effevee/effevees_weerstation/documentatie/effevees_weerstation.pdf

## Effevee’s Weerstation

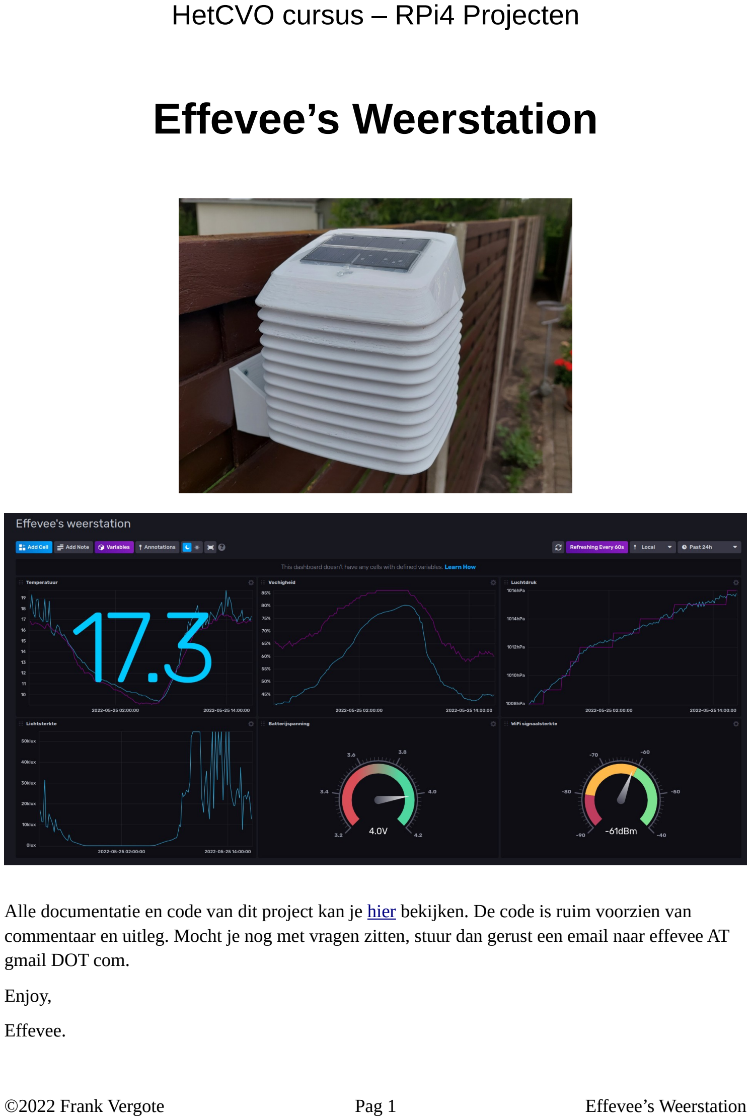
[picture p1: page 1]

HetCVO cursus – RPi4 Projecten

Alle documentatie en code van dit project kan je hier (https://github.com/effevee/effevees_weerstation) bekijken. De code is ruim voorzien van commentaar en uitleg. Mocht je nog met vragen zitten, stuur dan gerust een email naar effevee AT gmail DOT com.

Enjoy,

Effevee.

©2022 Frank Vergote | Pag 1 | Effevee’s Weerstation

Inhoudsopgave

©2022 Frank Vergote | Pag 2 | Effevee’s Weerstation

©2022 Frank Vergote | Pag 3 | Effevee’s Weerstation

Beschrijving

Effevee’s weerstation bestaat uit een buiten meetstation gebaseerd op een ESP32 (https://www.espressif.com/en/products/socs/esp32) microcontroller met sensoren voor temperatuur, vochtigheid, luchtdruk en licht intensiteit. Het autonome meetstation wordt gevoed door een lithium 18650 batterij met aangepaste 3,3V spanningsregelaar. De batterij wordt met een 6V 100mA 0,6W zonnepaneeltje en een TP4056 controller veilig opgeladen. De sturing van het meetstation is geprogrammeerd in MicroPython. (https://micropython.org/)

De meetresultaten inclusief de batterijspanning en de WiFi signaalsterkte worden doorgegeven naar de Raspberry Pi (https://www.raspberrypi.org/) backend mosquitto (https://mosquitto.org/) MQTT broker. Deze worden vervolgens met tele (https://docs.influxdata.com/telegraf/v1.21/) g (https://docs.influxdata.com/telegraf/v1.21/) raf (https://docs.influxdata.com/telegraf/v1.21/) doorgestuurd naar een influxdb (https://www.influxdata.com/) database. De meetgegevens worden tenslotte gevisualiseerd in een influxdb dashboard (Chronograf) in de browser. Als de batterijspanning te laag wordt stuurt influxdb (Kapacitor) een email. Alle nodige software op de backend wordt met docker (https://www.docker.com/) containers geïnstalleerd.

Materiaal

Meetstation

- DOIT ESP-WROOM-32 ontwikkelbordje
- AM2320 temperatuur- en vochtigheidssensor
- BMP180 luchtdruk- en temperatuursensor
- BH1750 licht intensiteitssensor
- Lithium Ion 18650 batterij 2500 mAh + batterijhouder
- Zonnepaneel 6V 100mA 0,6W – 90x60 mm
- TP4056 lithium batterij laad- en beschermingsmodule + 10k weerstand
- HT7333 3,3V spanningsregelaar + 2 100µF/16V elektrolytische condensatoren
- Batterijspanning monitoring : weerstanden 27k + 100k, condensator 100nF

Backend

- Raspberry Pi 4 Model B 2GB
- Aluminium passieve koeler behuizing
- SanDisk Ultra Fit USB 3.1 Flash Drive
- Originele Pi USB-C 3A voeding
©2022 Frank Vergote | Pag 4 | Effevee’s Weerstation

Meetstation

Microcontroller

We maken gebruik van het DOIT ESP-WROOM-32 ontwikkelbordje dat vlot verkrijgbaar is. De ESP32 heeft 2 processor cores aan boord, communiceert via WiFi en BLE (bluetooth low energy). De klok gaat tot 240 MHz. Er is 4 MB RAM geheugen en allerlei protocollen worden ondersteund zoals capacitive touch, ADC, DAC UART, SPI, I2C, …

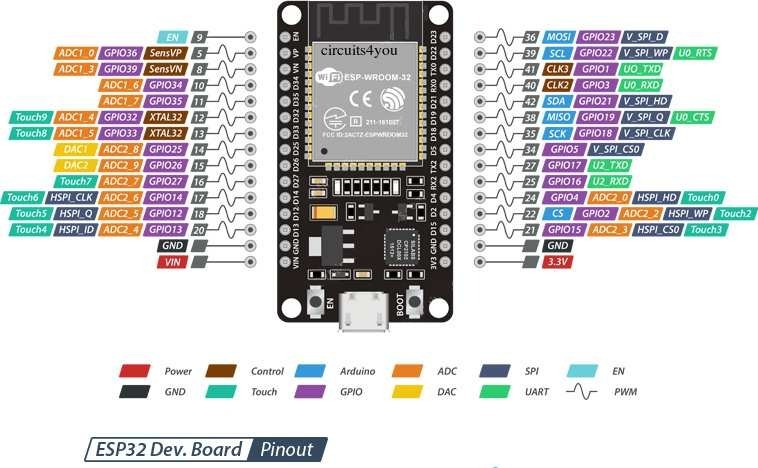
[picture p2: figure]

©2022 Frank Vergote | Pag 5 | Effevee’s Weerstation

Sensoren

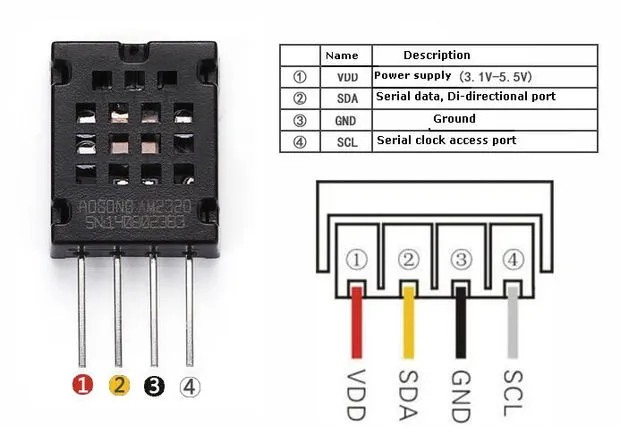
[picture p3: figure]

AM2320 temperatuur- en
vochtigheidssensor

De AOSONG AM2320 compacte sensor is de opvolger van de verouderde DT11/DT22 sensoren. De sensor is redelijk nauwkeurig, vergt weinig stroom en is simpel aan te sturen via I2C op adres 0x5C.

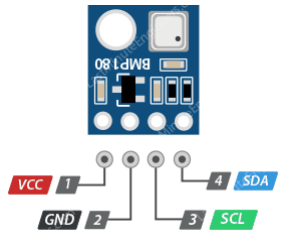
[picture p4: figure]

BMP180 luchtdruk- en temperatuursensor

De Bosch BMP180 is een zeer energiezuinige barometrische druksensor met hoge gevoeligheid. Doordat de druk in relatie staat tot de hoogte waarop je je bevindt kun je ook uitrekenen op welke hoogte boven zeeniveau de sensor zich bevindt. De sensor is aan te sturen via I2C op adres 0xD0.

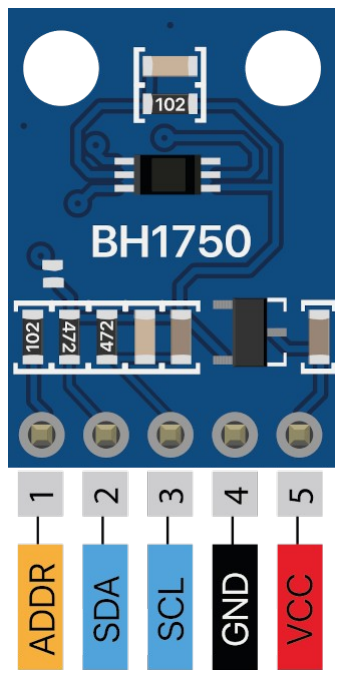
[picture p5: figure]

BH1750 licht intensiteitssensor

De Mouser BH1750 sensor wordt eveneens aangestuurd via I2C op adres 0x23, heeft een hoge resolutie (1-65235 lux) en is energie zuinig met zijn powerdown functie.

©2022 Frank Vergote | Pag 6 | Effevee’s Weerstation

Voeding

De voeding bestaat uit volgende onderdelen :

Lithium Ion 18650 batterij 2500 mAh

Een lithium ion batterij heeft een hoge energiedichtheid en een geringe zelfontlading. Bovendien heeft ze geen last van geheugeneffect (capaciteitsvermindering bij opladen voordat ze volledig ontladen is). De nominale spanning (bij 50% lading) is 3,7V. Bij volledig opladen moet de spanning beperkt worden tot 4,2V. Het is af te raden om de cel onder de 2,4V te laten ontladen. De cel kan ongeveer 2000 keer volledig geladen/ontladen worden. Niet gebruikte cellen worden best op hun nominale spanning bij kamertemperatuur gestockeerd.

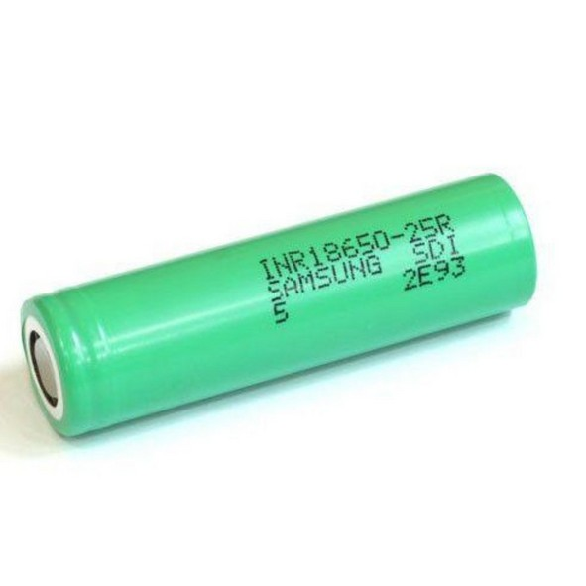
[picture p6: figure]
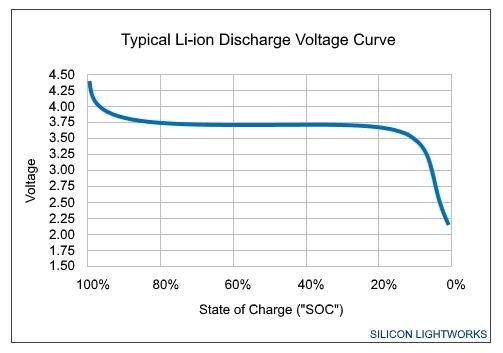
[picture p7: figure]

Hiernaast zie je een typische ontlaad curve van een lithium ion cel. De maximale spanning van 4,2V verlaagt heel snel naar de nominale spanning van 3,7V maar die blijft dan heel lang stabiel tot ongeveer 10% van de lading. Daarna gaat het heel snel bergaf tot de minimum spanning.

Zonnepaneel 6V 100mA 0,6W – 90x60 mm

Dit paneeltje bevat 12 cellen die elk ongeveer 0,5V kunnen leveren.

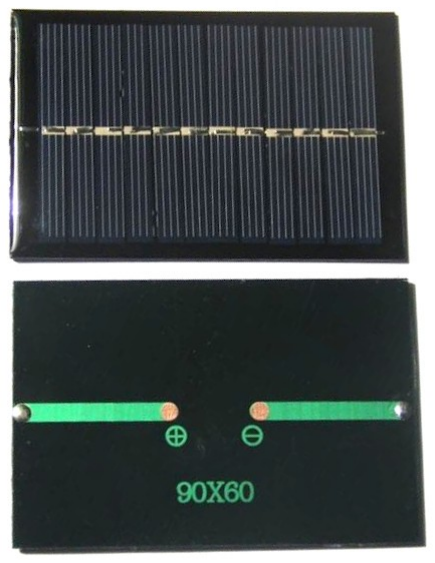
[picture p8: figure]

©2022 Frank Vergote | Pag 7 | Effevee’s Weerstation

TP4056 lithium batterij laad-en beschermingsmodule

Deze TP4056 (https://www.addicore.com/TP4056-Charger-and-Protection-Module-p/ad310.htm) beschermings (https://www.addicore.com/TP4056-Charger-and-Protection-Module-p/ad310.htm) module (https://www.addicore.com/TP4056-Charger-and-Protection-Module-p/ad310.htm) bevat een TP4056 chip die een 3,7V lithium batterij oplaadt via een constante stroom/constante spanning methode (CC/CV) tot 4,2V.

De DW01A chip houdt de spanning van de batterij in de gaten en stuurt de FS8204A transistor om de load af te schakelen indien de spanning onder de 2,4V dreigt te gaan. Die blijft afgeschakeld tot de spanning terug boven de 3,0V is. Daarnaast zorgt deze beschermingschip er ook voor dat de batterij tot maximaal 4,2V geladen wordt en dat de ontlaad stroom onder de 3A blijft.

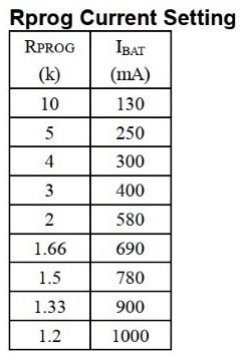
[picture p9: figure]

Als de spanning onder de 2,9V ligt
wordt de batterij met een verlaagde

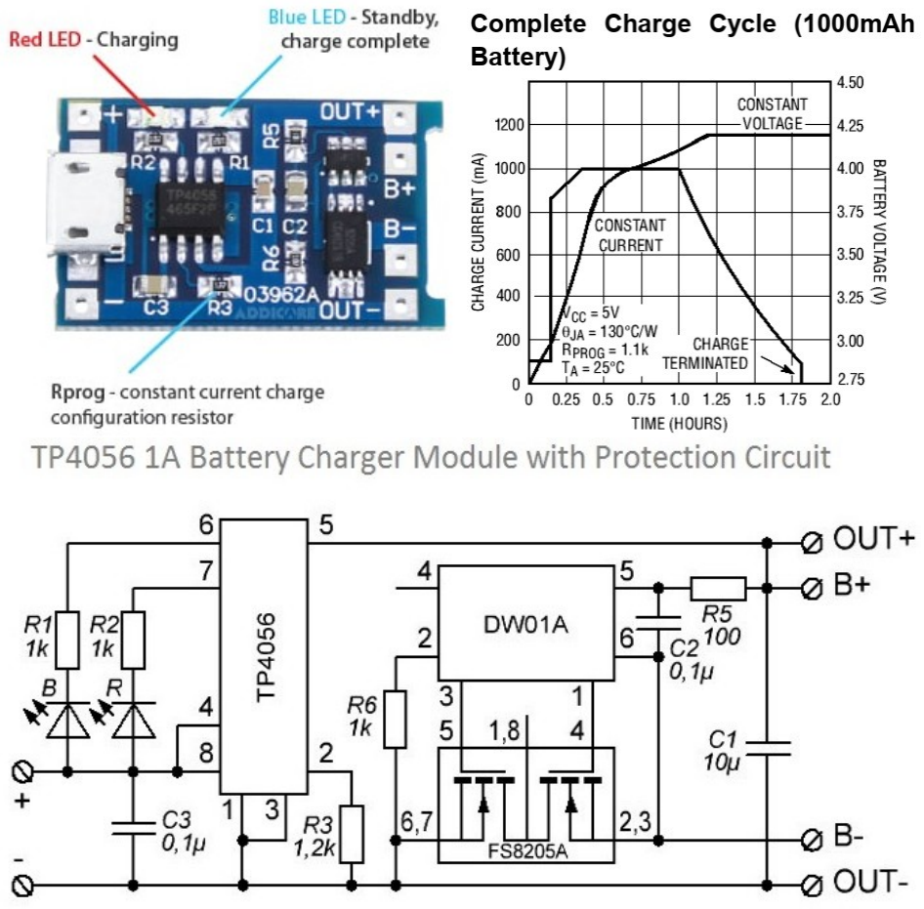
[picture p10: figure]

stroom (130mA) opgeladen tot 2,9V. Daarna wordt de stroom lineair opgevoerd tot de maximum laadstroom die bepaald wordt door de waarde van de weerstand R3 op de module (standaard 1,2k = 1A)

Het zonnepaneeltje levert maximaal 100 mA stroom, dus kunnen we de TP4056 module best aanpassen voor deze stroom. Hiervoor heb ik een 10k gesoldeerd op R3 zodat de laadstroom beperkt wordt tot 130mA. Het zonnepaneel levert maximaal 6V en kan dus rechtstreeks op de input van de TP4056 module worden aangesloten (max 8V input)

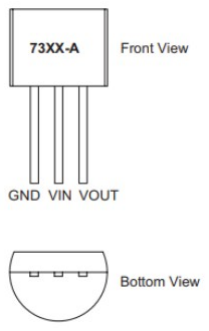
[picture p11: figure]

HT7333 3,3V spanningsregelaar

De gewone spanningsregelaars hebben een dropout spanning van ongeveer 1V. De regelaar werkt enkel als Vin > Vout + Vdropout. In ons geval zou dat betekenen dat de ingangsspanning hoger dan 4,3V moet zijn om onze gewenste uitgangsspanning van 3,3V te bekomen. Onze lithium cel heeft slechts een maximale spanning van 4,2V en een nominale spanning van 3,7V. Dus is een gewone spanningsregelaar onbruikbaar. We hebben een LDO (low dropout) spanningsregelaar zoals de HT7333 nodig die maar een dropout spanning van 90mV heeft. De regelaar blijft dus werken tot een ingangsspanning van ongeveer 3,4V.

©2022 Frank Vergote | Pag 8 | Effevee’s Weerstation

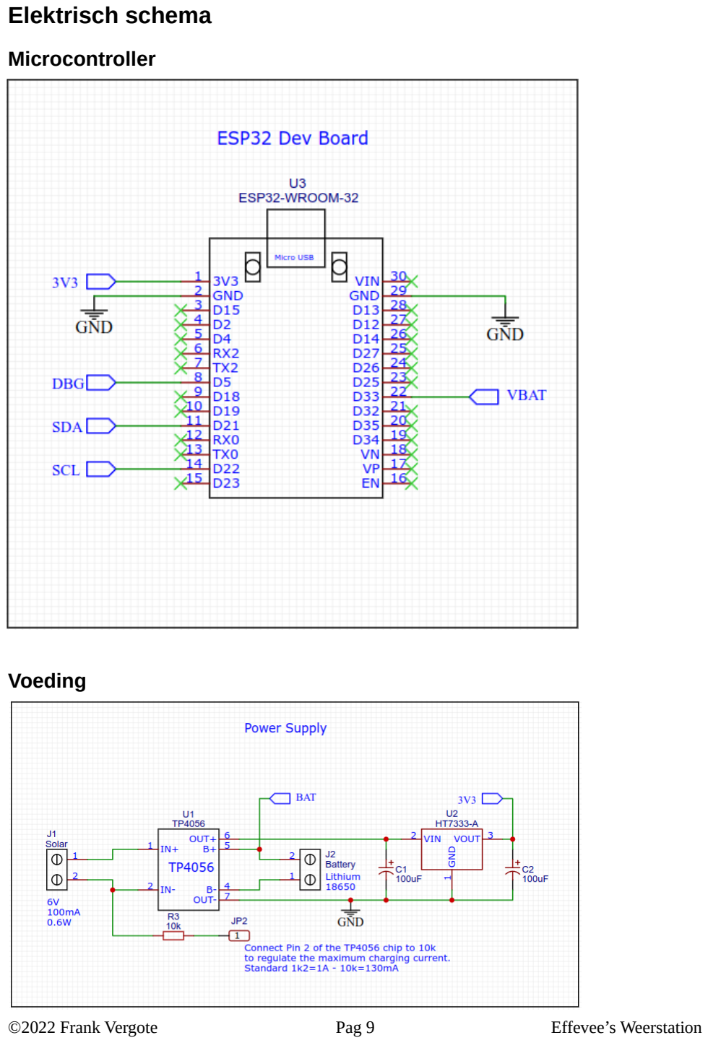
[picture p12: page 9]

Elektrisch schema

Microcontroller

Voeding

©2022 Frank Vergote | Pag 9 | Effevee’s Weerstation

Sensoren

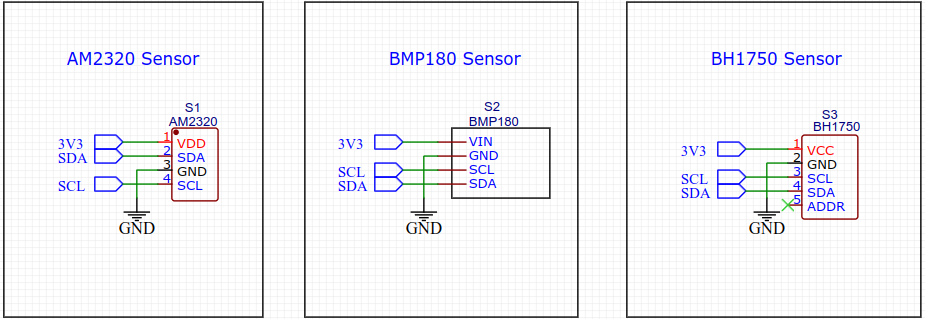
[picture p13: figure]

Batterijspanning monitoring

We lezen de spanning van de Li-Ion 18650 batterij uit via de GPIO 33 pin van de ESP32 microcontroller. Daar de spanning op deze pin

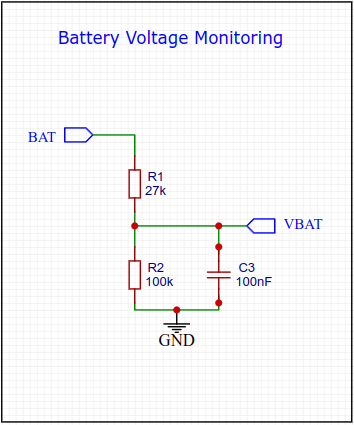
[picture p14: figure]

maximaal 3,3V mag zijn, moeten we gebruik maken van een spanningsdeler R1 en R2.

VBAT = BAT * R2 / (R1 + R2)

VBAT = 4,2V * 100k / (100k + 27k) = 4,2V * 100k / 127k = 4,2V * 0,79 = 3,3V

De condensator C3 vangt eventuele spanningspieken op om de ESP32 pin te beschermen.

©2022 Frank Vergote | Pag 10 | Effevee’s Weerstation

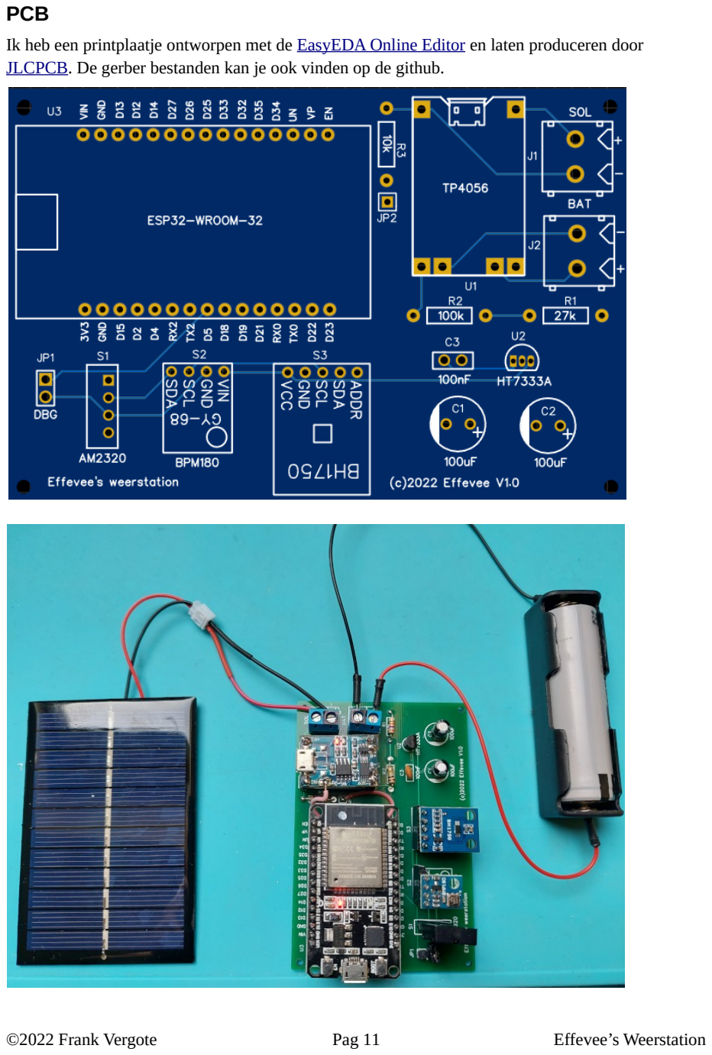
[picture p15: page 11]

PCB

Ik heb een printplaatje ontworpen met de EasyED (https://easyeda.com/) A Online Editor (https://easyeda.com/) en laten produceren door JLCPCB. (https://jlcpcb.com/) De gerber bestanden kan je ook vinden op de github.

©2022 Frank Vergote | Pag 11 | Effevee’s Weerstation

Behuizing

Stevenson hut

De behuizing is gebaseerd op een zogenaamde Stevenson hut of thermometer hut in de volksmond. De sensoren bevinden zich in een wit kastje met wanden die de vorm hebben van een open jaloezie. Daardoor heeft de wind vrij spel, maar zon en neerslag kunnen niet tot de instrumenten doordringen.

Officieel moet deze opstelling zich anderhalve meter boven een open grasvlakte bevinden, maar bij mij hangt hij aan de schutting ;-)

Het zonnepaneeltje is aan de bovenkant ingebouwd en is verbonden met de elektronica in de behuizing.

3D filament

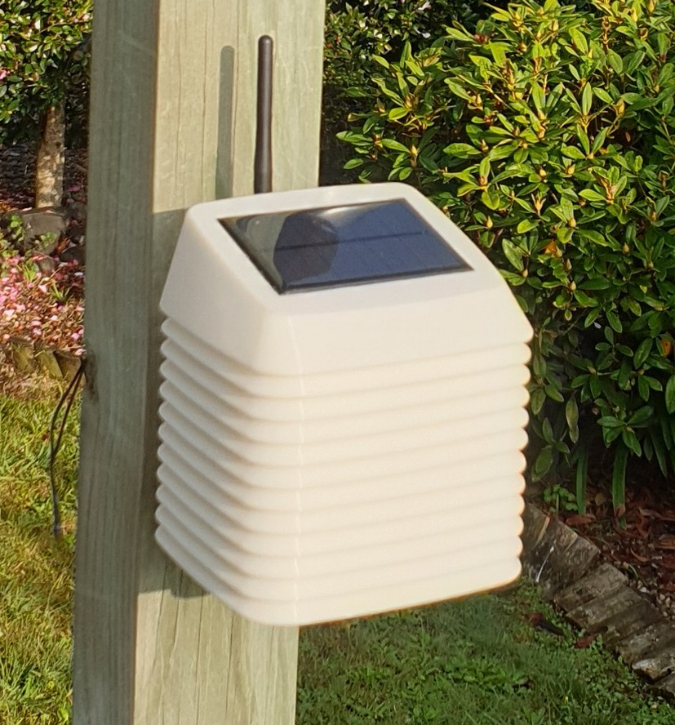
[picture p16: figure]

Doordat het meetstation zich buiten bevindt moet de behuizing bestand zijn tegen allerlei weersomstandigheden en ook tegen de UV straling van de zon. Hierdoor valt het veelgebruikte PLA (https://nl.wikipedia.org/wiki/Polymelkzuur) af. Dit is een biologisch afbreekbare kunststof gebaseerd op maiszetmeel of suikerriet.

Er is gekozen voor PETG (https://nl.wikipedia.org/wiki/Polyethyleentereftalaat) die een thermoplastische polyester is die onder andere ook gebruikt wordt voor PET flessen en allerhande verpakkingen voor de voeding. Voor de 3D print toepassing wordt hiervoor nog glycol toegevoegd zodat het materiaal transparant blijft en een lagere smelt temperatuur heeft. Het is ook heel wat sterker dan PLA en resistent tegen UV licht.

3D model

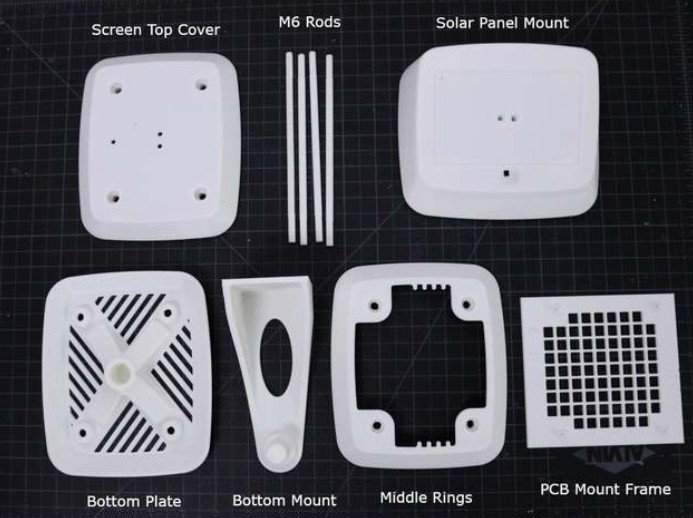
[picture p17: figure]

Ik heb deze behuizing (https://www.thingiverse.com/thing:3615016) geprint met
mijn Creality Ender 3 3D printer. Het ontwerp is modulair opgebouwd en bevat een aantal concentrische ringen waarbinnen de elektronica en de sensoren worden ingebouwd. Een bovenplaat met een schuine kant bevat het zonnepaneel. De onderplaat past op een beugel waarmee het geheel kan worden gemonteerd tegen een paal.
©2022 Frank Vergote | Pag 12 | Effevee’s Weerstation

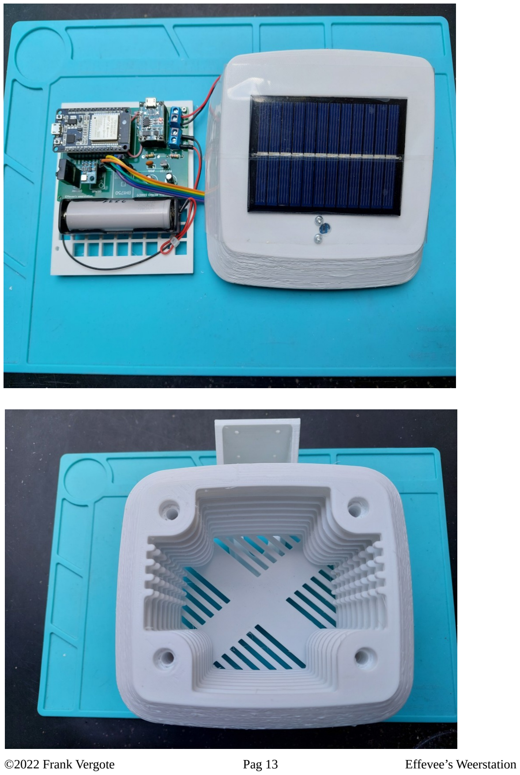
[picture p18: page 13]

©2022 Frank Vergote | Pag 13 | Effevee’s Weerstation

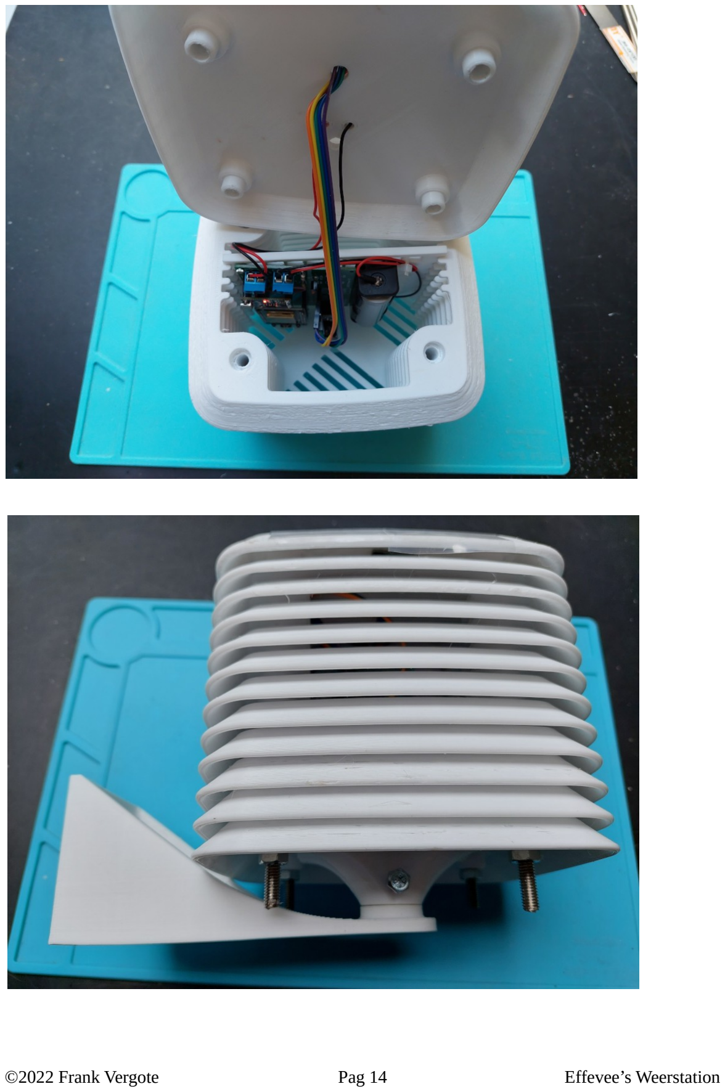
[picture p19: page 14]

©2022 Frank Vergote | Pag 14 | Effevee’s Weerstation

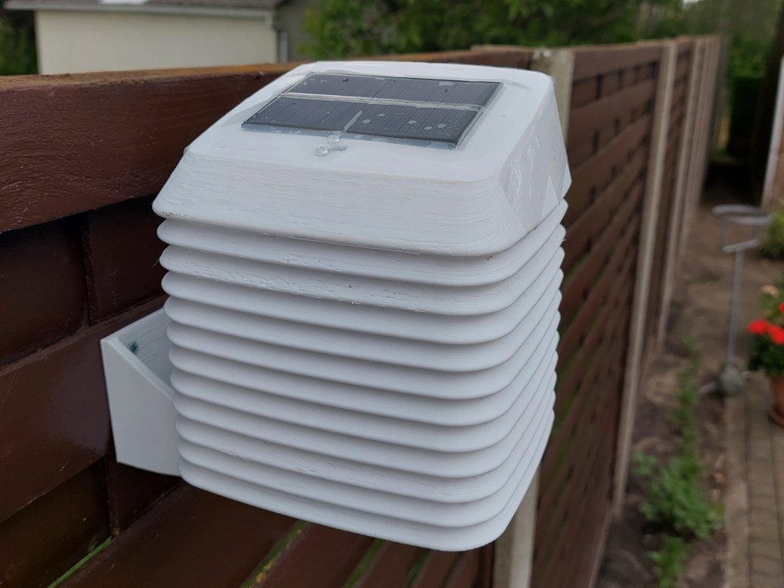
[picture p20: figure]

©2022 Frank Vergote | Pag 15 | Effevee’s Weerstation

Backend

Raspberry Pi

Ik gebruik hiervoor een Pi (https://www.sossolutions.nl/raspberry-pi-4-model-b-2gb) 4 Model B 2GB (https://www.sossolutions.nl/raspberry-pi-4-model-b-2gb)

Case

De Pi is uitgerust met een aluminium passieve koel (https://www.sossolutions.nl/raspberry-pi-4-aluminium-koeling-heatsink) er (https://www.sossolutions.nl/raspberry-pi-4-aluminium-koeling-heatsink) behuizing

USB 3.1 Flash Drive

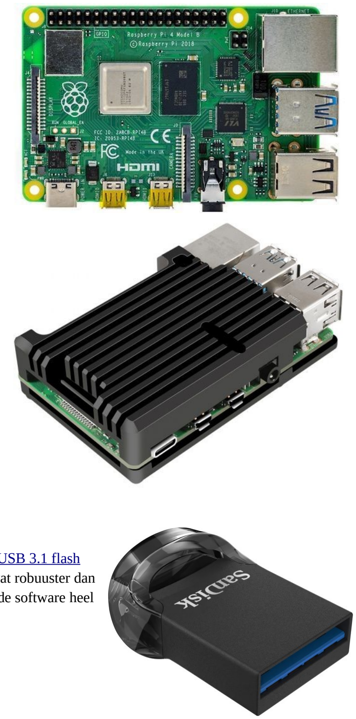
[picture p21: figure]

Het OS wordt op een SanDisk Ultra Fit USB 3.1 flash drive (https://www.coolblue.be/nl/product/809157/sandisk-ultra-fit-16gb.html) van 16GB gebrand. Deze is heel wat robuuster dan een microSD kaartje, vooral ook omdat de software heel wat lees- en schrijf acties zal genereren.

©2022 Frank Vergote | Pag 16 | Effevee’s Weerstation

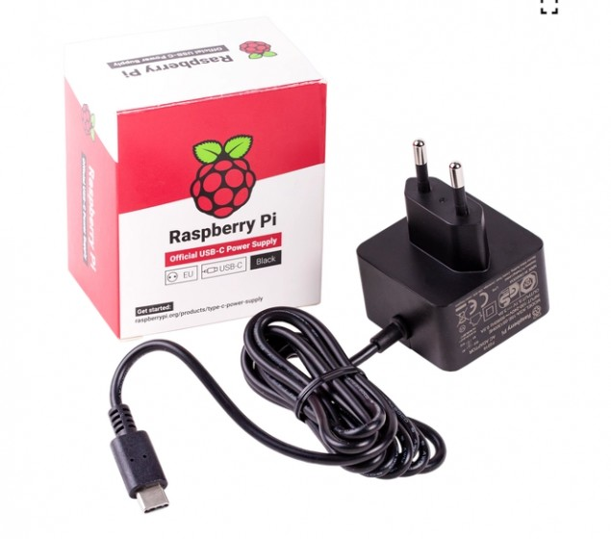
[picture p22: figure]

Voeding

Ik gebruik de originele Pi USB-C 3A (https://www.sossolutions.nl/originele-raspberry-pi-foundation-usbc-3a-voeding-zwart) voeding

©2022 Frank Vergote | Pag 17 | Effevee’s Weerstation

InfluxDB database

De gegevens van het meetstation en de OpenWeatherMap voorspelling zullen we opslaan in een Influxdb2 database.

Data structuur

bucket (database) | weatherdata
measurements (tabellen) | forecasts | actuals
tags (index velden) | source=’OpenWeatherMap’ location=’Ingelmunster,BE’ | source=’weerstation’ location=’Ingelmunster,BE’
fields (velden) | ow_temp (float) ow_hum (float) ow_pres (float) | ac_temp (float) ac_hum (float) ac_pres (float) ac_lum (float) ac_vbat (float) ac_rssi (integer)
timestamps (tijd veld) | time (timestamp) | time (timestamp)

Velden

- *_temp : temperatuur in °C
- *_hum : vochtigheid in %
- *_pres : luchtdruk in hPa
- ac_lum : lichtintensiteit in lux
- ac_vbat : batterij spanning in Volt
- ac_rssi : WiFi signaal sterkte in dBm

Lijn protocol

Voor het schrijven van data naar de database moet een speciaal formaat worden gebruikt.

<measurement>[,<tag_key>=<tag_value>[,<tag_key>=<tag_value>]] <field_key>=<field_value>[,<field_key>=<field_value>] [<timestamp>]

Vertaald naar ons geval geeft dit de 2 volgende lijnen :

We geven geen timestamp mee; InfluxDB zal die automatisch toevoegen. Er moet een spatie staan tussen tags en fields !

©2022 Frank Vergote | Pag 18 | Effevee’s Weerstation

forecasts,source=”…”,location=”…” ow_temp=…,ow_hum=…,ow_pres=… actuals,source=”…”,location=”…” ac_temp=…,ac_hum=…,ac_pres=…,ac_lum=…,ac_vbat=…

Software

Meetstation

MicroPython (https://micropython.org/) is een implementatie van Python 3, geschreven in C en geoptimaliseerd om op microcontrollers te werken. Net zoals bij Python wordt de code niet gecompileerd, maar tijdens het uitvoeren geïnterpreteerd.

De sturing van het meetstation bevat volgende functionaliteit :

- verbinden met het lokale WiFi netwerk
- weervoorspelling ophalen van OpenWeatherMap.org
- sensoren en batterijspanning uitlezen

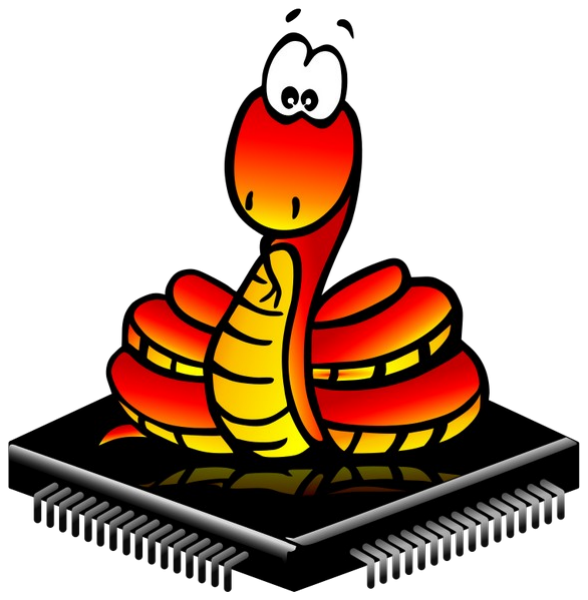
[picture p23: figure]

- meetwaarden doorsturen naar de MQTT broker op de RPi4 backend
- microcontroller in deepsleep brengen tot de volgende meting

MicroPython firmware

## Download firmware

De meest recente versie van MicroPython downloaden we hier. (https://micropython.org/download/esp32/) De installatie instructies staan op dezelfde pagina. We gebruiken hiervoor de esptool.py tool die je van de github van Espressif (https://github.com/espressif/esptool) kan halen.

## Wissen ESP32 flash

esptool.py --chip esp32 --port /dev/ttyUSB0 erase_flash

## Uploaden MicroPython naar ESP32 flash

esptool.py --chip esp32 --port /dev/ttyUSB0 --baud 460800 write_flash -z 0x1000 esp32-20220117-v1.18.bin

## Testen MicroPython op ESP32

picocom /dev/ttyUSB0 -b115200

Druk een paar keer op Enter en we krijgen de REPL prompt.

©2022 Frank Vergote | Pag 19 | Effevee’s Weerstation

Terminal ready

>>> print('Hello ESP32!')
Hello ESP32!
>>>

MicroPython code

## Modules

Module | Beschrijving | Installatie
machine | Hardware functies | (ingebouwd)
network | Netwerk configuratie | (ingebouwd)
json | JSON encoding/decoding | (ingebouwd)
umqtt.simple | MQTT functies | (ingebouwd)
urequests | HTTP bibliotheek | (ingebouwd)
sys | Systeem functies | (ingebouwd)
utime | Tijd gerelateerde functies | (ingebouwd)
am2320 | Aosong AM2320 I2C driver | https://github.com/mcauser/micropython-am2320 (https://github.com/mcauser/micropython-am2320)
bmp180 | Bosch BMP180 I2C driver | https://github.com/micropython-IMU/micropython-bmp180 (https://github.com/micropython-IMU/micropython-bmp180)
bh1750 | Mouser Electronics BH1750 I2C driver | https://github.com/PinkInk/upylib/tree/master/bh1750 (https://github.com/PinkInk/upylib/tree/master/bh1750)

## Configuratie

Module | Variabele | Beschrijving
config | SCL_PIN | I2C clock Pin
config | SDA_PIN | I2C data Pin
config | LED_PIN | Onboard LED Pin gebruikt als fout indicator
config | LED_ON & LED_OFF | Omgekeerde logica van onboard LED
config | DEBUG_PIN | Pin voor debug (LOW is debug AAN)
config | VBAT_PIN | Pin voor batterijspanning monitoring
config | FAHRENHEIT | Temperatuur in Fahrenheit (True/False)
config | INTERVAL | Interval tussen sensor metingen (seconden)
config | SSID & PASS | SSID en paswoord voor het WiFi netwerk
config | MAX_TRIES | Maximum aantal pogingen voor connectie op het WiFi netwerk (1 sec interval)
config | MQTT_HOST | MQTT host voor uploaden sensor metingen
©2022 Frank Vergote | Pag 20 | Effevee’s Weerstation

Module | Variabele | Beschrijving
config | MQTT_TOPIC | MQTT topic voor uploaden sensor metingen
config | OPENWEATHERMAP_API | OpenWeather API sleutel
config | OPENWEATHERMAP_CITY | OpenWeather stad,land voor weervoorspelling
config | OPENWEATHERMAP_LAT | OpenWeather latitude voor weervoorspelling
config | OPENWEATHERMAP_LON | OpenWeather longitude voor weervoorspelling
config | OPENWEATHERMAP_URL | OpenWeather url voor weervoorspelling

## Functies

Functie | Beschrijving
show_error() | Fout conditie laat de onboard LED knipperen
debug_on() | Controle debug pin LOW (debug AAN)
connect_wifi() | Verbinden µcontroller met het WiFi netwerk
get_weather_data() | Ophalen van de weervoorspelling van OpenWeatherMap.org
temperature_2_unit() | Geef de temperatuur weer in de juiste eenheid ( config.FAHRENHEIT)
get_sensor_readings() | Lees de waarden van de sensoren uit
log_readings() | Stuur de metingen via MQTT naar de backend
deepsleep_till_next_cycle() | Breng de µcontroller in deepsleep voor config.INTERVAL seconden
run() | Programma logica

De volledige source code kan je hier (https://github.com/effevee/effevees_weerstation/blob/main/meetstation/source/esp32/meetstation.py) vinden.

©2022 Frank Vergote | Pag 21 | Effevee’s Weerstation

Backend

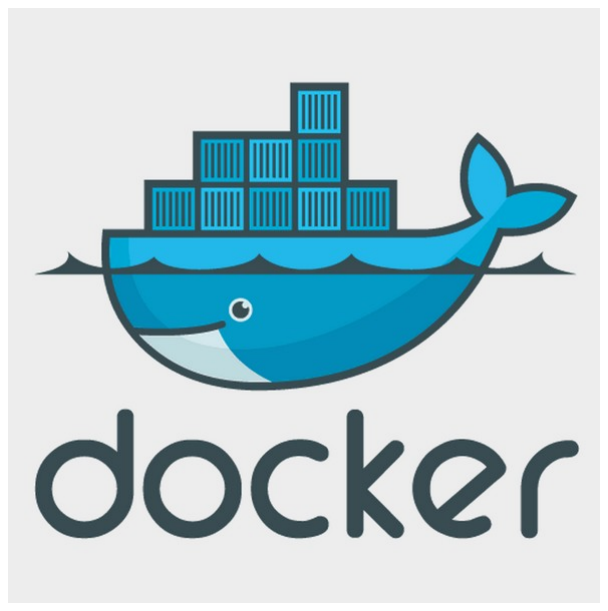
[picture p24: figure]

De backend draait op een Raspberry Pi 4B 2GB en het Raspberry Pi Bullseye 64bit OS. Voor het verwerken van de meetgegevens zullen we gebruik maken van volgende docker (https://www.docker.com/) images:
- Mosquitto : MQTT broker voor het ontvangen van de meetwaarden van het meetstation.
- Telegraf : agent voor het doorsturen van de MQTT meetwaarden naar de database
- InfluxDB : tijd gerelateerde database voor het opslaan van de meetwaarden, het visualiseren en monitoren ervan

In InfluxDB 2.x zijn de
database (InfluxDB), de

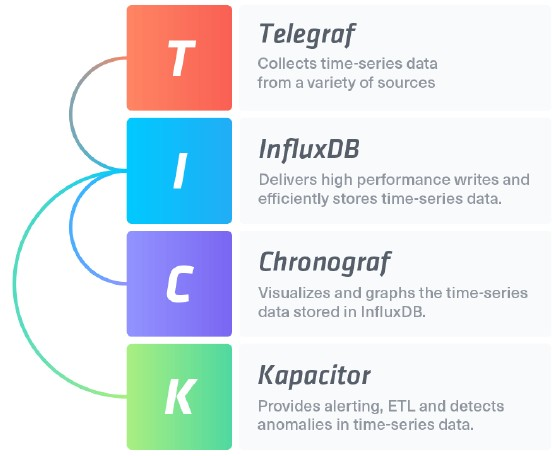
[picture p25: figure]

visualisatie (Chronograf) en monitoring (Kapacitor)
geïntegreerd in één pakket en vormen ze te samen met
Telegraf de zogenaamde
TICK stack (https://scriptbees.com/what-is-tick-stack-and-why-should-we-consider-using-it/) die een mooie
oplossing biedt voor onze
noden.

Als je kiest voor InfluxDB 1.x kan je hetzelfde
opzetten maar dan moet je
wel Chronograf en
Kapacitor zelf installeren en mis je de geïntegreerde web UI van versie 2.x

We zullen deze docker containers configureren in een YAML file en besturen met docker-compose. (https://docs.docker.com/compose/)

©2022 Frank Vergote | Pag 22 | Effevee’s Weerstation

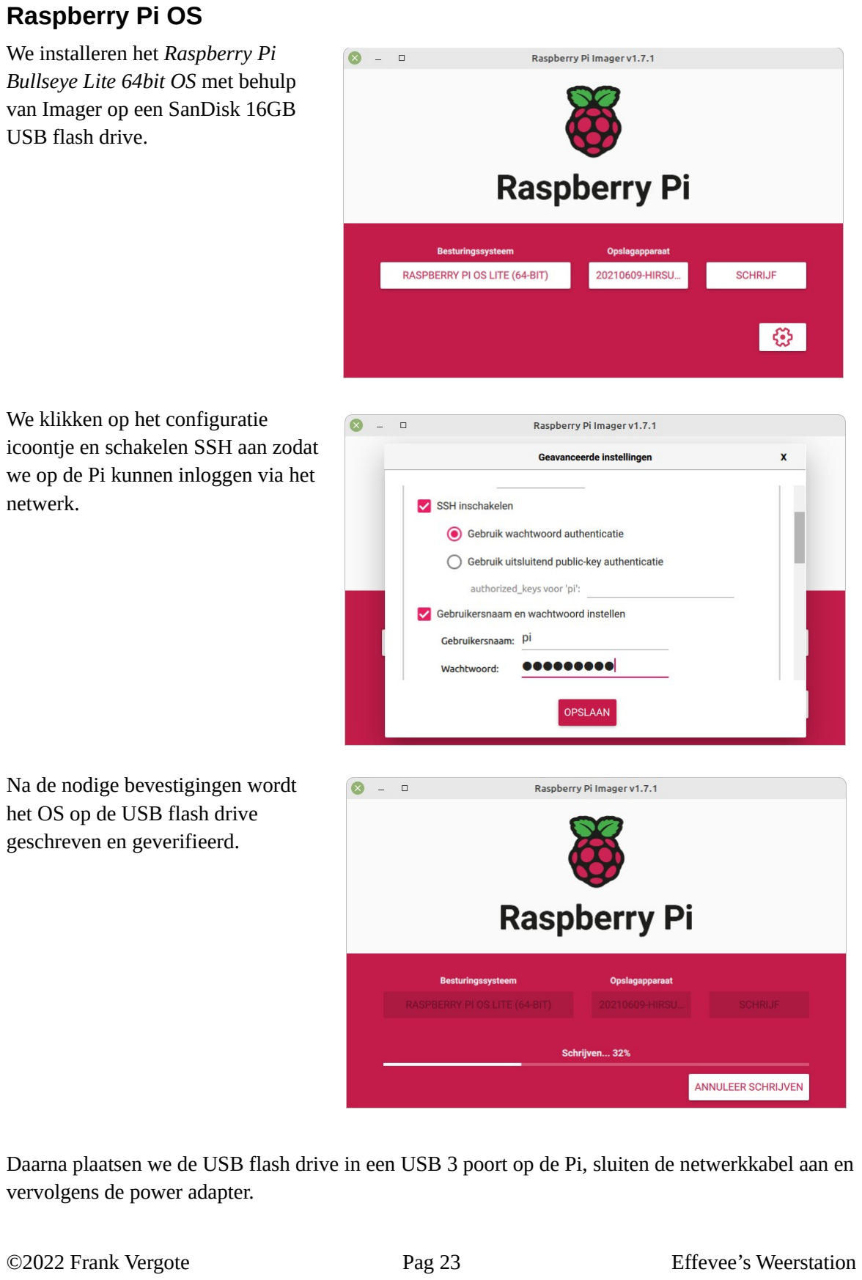
[picture p26: page 23]

Raspberry Pi OS

We installeren het Raspberry Pi Bullseye Lite 64bit OS met behulp van Imager op een SanDisk 16GB USB flash drive.

We klikken op het configuratie icoontje en schakelen SSH aan zodat we op de Pi kunnen inloggen via het netwerk.

Na de nodige bevestigingen wordt het OS op de USB flash drive geschreven en geverifieerd.

Daarna plaatsen we de USB flash drive in een USB 3 poort op de Pi, sluiten de netwerkkabel aan en vervolgens de power adapter.

©2022 Frank Vergote | Pag 23 | Effevee’s Weerstation

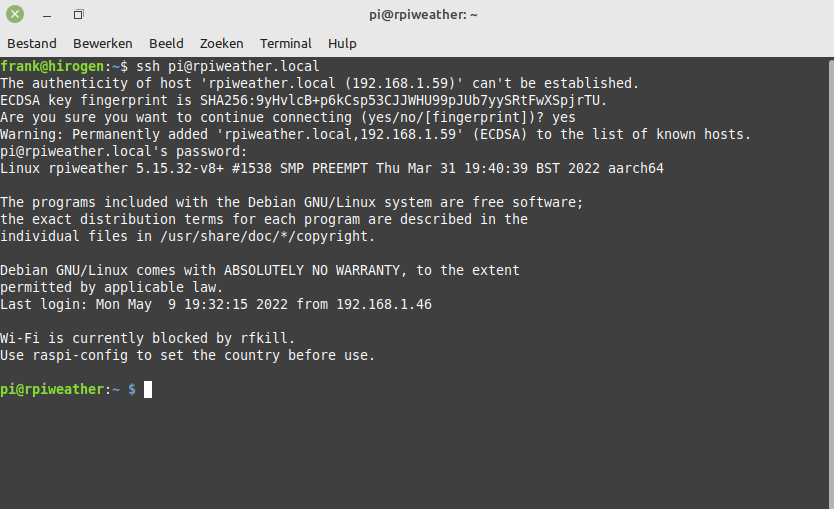
[picture p27: figure]

Nadat de RPi is opgestart loggen we in via SSH :

## ssh pi@rpiweather.local

Bij de eerste inlog kent ssh de host nog niet en moeten we bevestigen met yes om die toe te voegen aan de lijst van de known hosts.

Geef vervolgens het wachtwoord en je bent ingelogd.

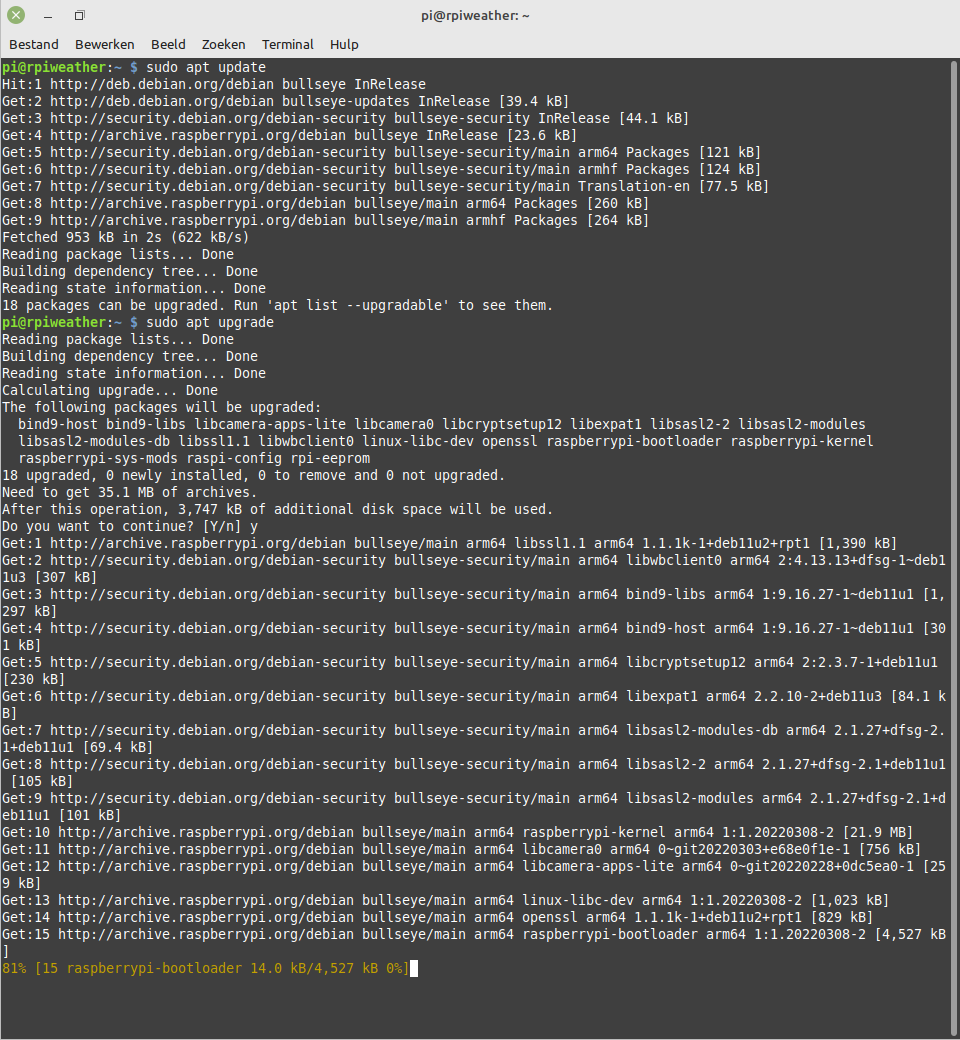
[picture p28: figure]

We werken het OS bij met :

## sudo apt update sudo apt upgrade -y

©2022 Frank Vergote | Pag 24 | Effevee’s Weerstation

## curl -sSL https://get.docker.com | sh

## systemctl status docker.service

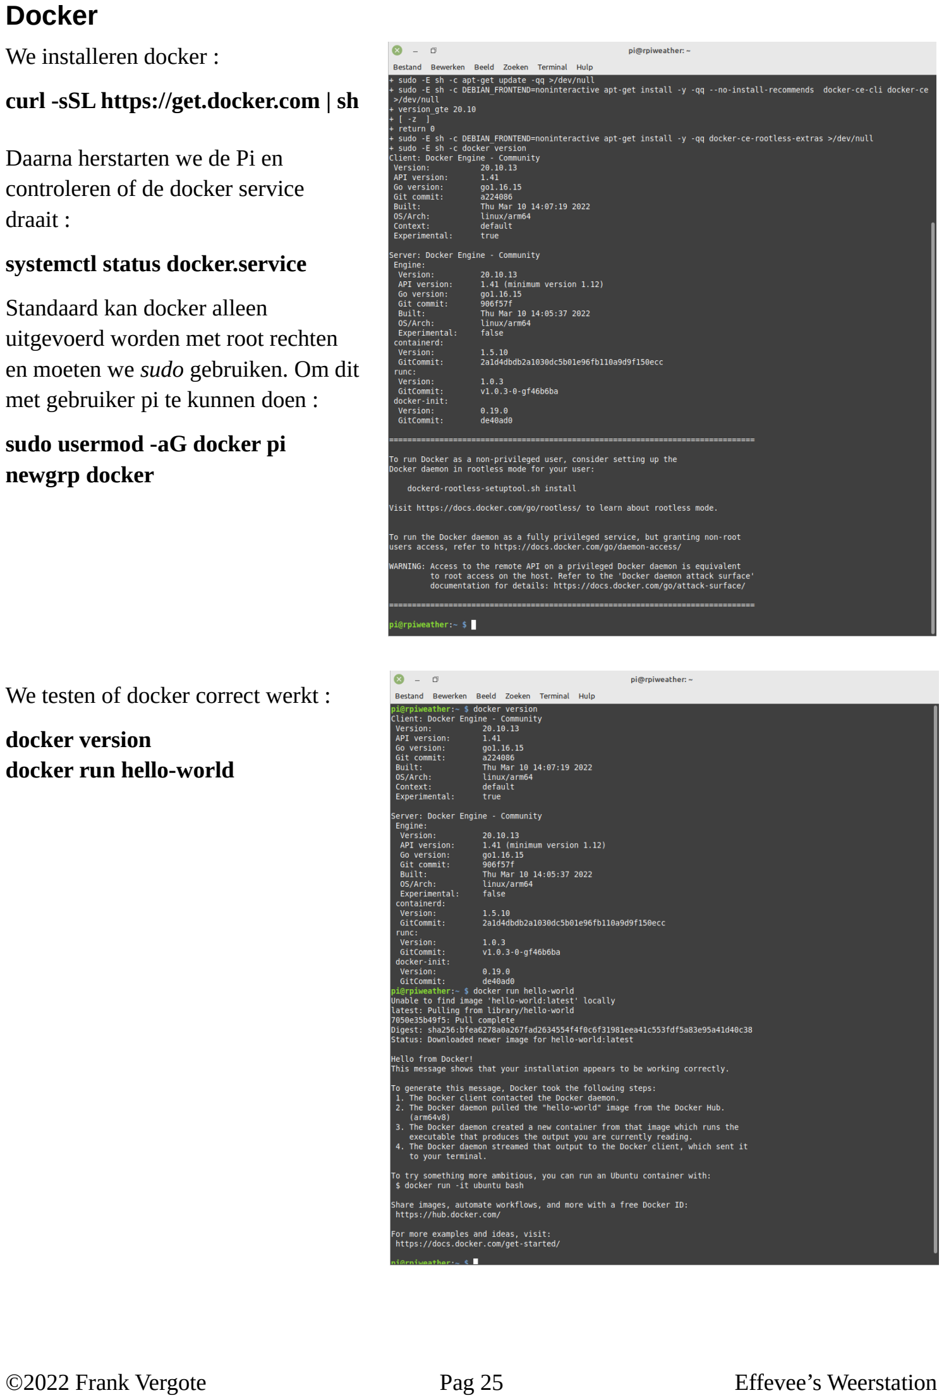
[picture p29: page 25]

Docker

We installeren docker :

Daarna herstarten we de Pi en controleren of de docker service draait :

Standaard kan docker alleen uitgevoerd worden met root rechten en moeten we sudo gebruiken. Om dit met gebruiker pi te kunnen doen :

## sudo usermod -aG docker pi newgrp docker

We testen of docker correct werkt :

## docker version docker run hello-world

©2022 Frank Vergote | Pag 25 | Effevee’s Weerstation

Docker-Compose

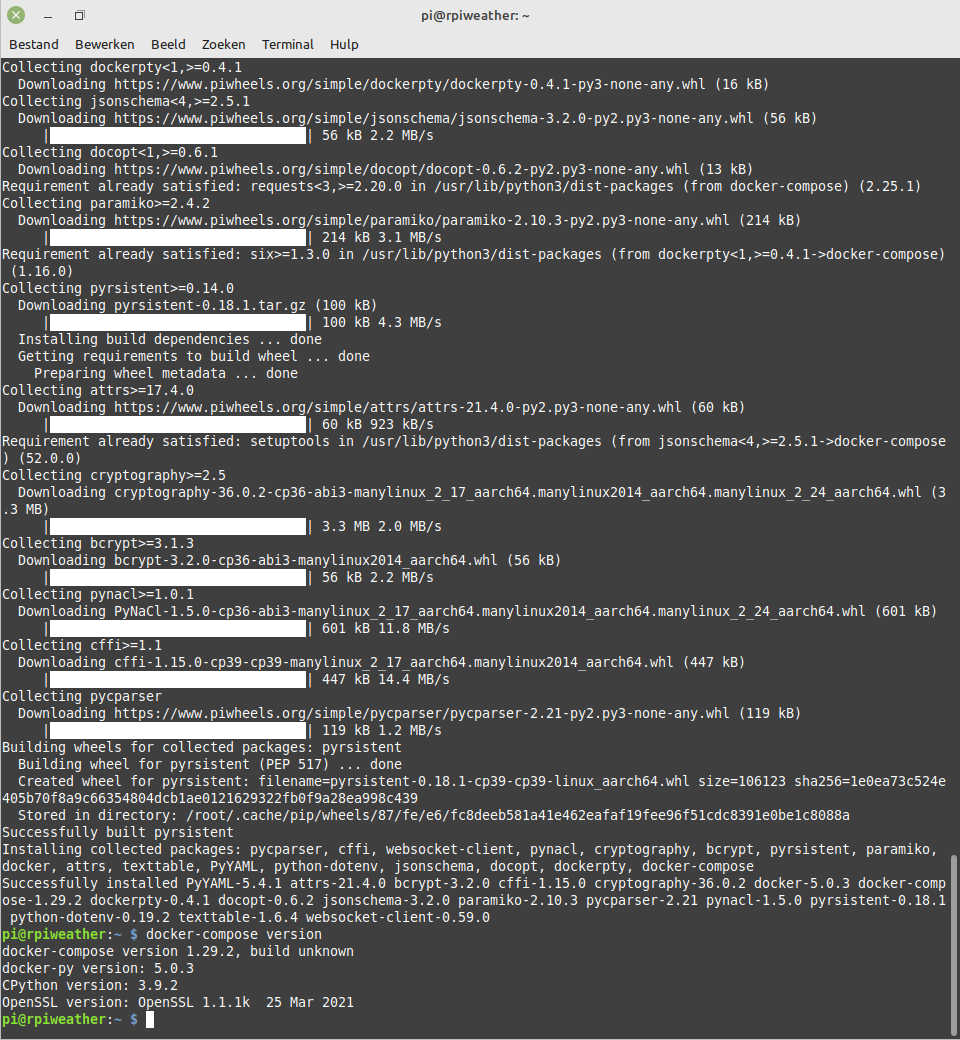
[picture p30: figure]

Dit moet met pip3 geïnstalleerd worden.

## sudo apt install python3-pip sudo pip3 install docker-compose

Alle gebruikte images zullen in docker-compose.yaml worden geconfigureerd zodat ze met één docker-compose commando
gezamenlijk kunnen worden
bestuurd.

We zetten deze folderstructuur op :

└── docker
├── mosquitto
└── telegraf

Docker network

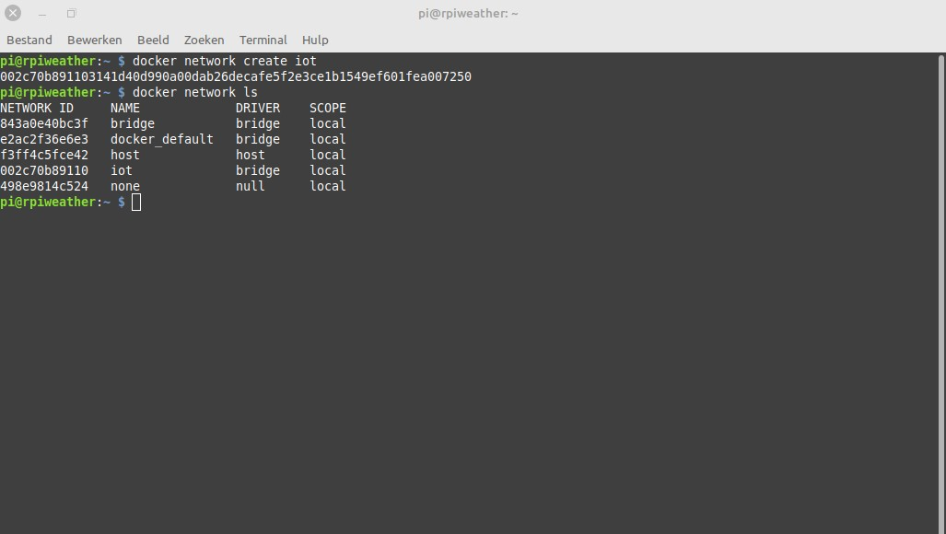
[picture p31: figure]

Omdat alle docker containers data met elkaar moeten kunnen
uitwisselen laten we ze draaien in hun eigen netwerk iot. Hiervoor kunnen ze elkaar aanroepen op naam i.p.v. op IP adres.

## docker network create iot docker network ls

©2022 Frank Vergote | Pag 26 | Effevee’s Weerstation

Docker containers

## Eclipse Mosquitto

In deze image zijn folders voorzien voor configuratie, data en logging. We zullen de default waarden voor deze parameters instellen via een lokaal configuratie bestand mosquitto.conf.

Vanaf versie 2.0 van mosquitto moet je een authenticatie methode configureren voor clients. Bij vroegere versies konden clients zonder gebruikersnaam en paswoord verbinden met de server. We stellen hier in dat clients op poort 1883 toch nog anoniem kunnen verbinden.
De rest van de configuratie heeft te maken met de persistentie van de gegevens en de logs na het herstarten van de container. Standaard begint de container bij een (her)start terug met een schone lei, d.w.z. dat alle gegevens van de vorige run verloren zijn gegaan. In vele gevallen is dit niet wenselijk en moeten we maatregelen treffen om de gegevens te bewaren.
Dit doen we door zogenaamde named volumes te configureren. De gegevens van de container worden gemapt naar deze named volumes op de host RPi. De named volumes bevinden zich in de
folder /var/lib/docker/volumes op de raspberry pi.

Het docker-compose bestand voor deze image bevat instructies hoe de image moet worden gestart.

We kunnen nu de image met één eenvoudig commando starten :

## docker-compose up

©2022 Frank Vergote | Pag 27 | Effevee’s Weerstation

mosquitto.conf

listener 1883
allow_anonymous true
persistence true
persistence_location /mosquitto/data/ log_dest file /mosquitto/log/mosquitto.log

docker-compose.yaml (mosquitto)

version: "3.8"

services:
mosquitto:
container_name: mosquitto
image: eclipse-mosquitto:2.0 ports:
- "1883:1883"
- "9001:9001"
networks:
- iot
volumes:
- ./mosquitto/mosquitto.conf:/mosquitto/config/mosquitto.conf:ro
- mosquitto-data:/mosquitto/data
- mosquitto-log:/mosquitto/log

networks:
iot:

volumes:
mosquitto-data:
mosquitto-log:

## Influxdb

De database is vanaf de versie 2.x ingrijpend veranderd t.o.v. de 1.x in de manier waarop ze geconfigureerd moet worden. Gelukkig bestaat er een officiële image die veel van de configuratie automatiseert. We kunnen een set-up configureren die automatisch een gebruiker, wachtwoord, organisatie, bucket (=database) en token aanmaakt. De parameters voor deze set-up worden via omgevingsvariabelen doorgegeven.
We configureren uiteraard ook named volumes om de data en configuratie persistent te maken.

Voor de veiligheid plaatsen we alle gevoelige informatie zoals paswoorden en tokens in een .env bestand in onze docker directory zodat we in de docker-compose.yaml deze kunnen aanroepen met

## ${variabele}

We starten de images nu op met het gekende docker-compose up commando.

©2022 Frank Vergote | Pag 28 | Effevee’s Weerstation

docker-compose.yaml (influxdb)

version: "3.8"

services:
mosquitto:

influxdb:
container_name: influxdb
image: influxdb:2.2
ports:
- "8086:8086"
networks:
- iot
environment:
- DOCKER_INFLUXDB_INIT_MODE=setup
- DOCKER_INFLUXDB_INIT_USERNAME=${DOCKER_INFLUXDB_INIT_USERNAME}
- DOCKER_INFLUXDB_INIT_PASSWORD=${DOCKER_INFLUXDB_INIT_PASSWORD}
- DOCKER_INFLUXDB_INIT_ORG=effevee
- DOCKER_INFLUXDB_INIT_BUCKET=weatherdata
- DOCKER_INFLUXDB_INIT_RETENTION=365d
- DOCKER_INFLUXDB_INIT_ADMIN_TOKEN=${DOCKER_INFLUXDB_INIT_ADMIN_TOKEN} volumes:
- influxdb-config:/etc/influxdb2
- influxdb-data:/var/lib/influxdb2

networks:
iot:

volumes:
mosquitto-data:
mosquitto-log:
influxdb-config:
influxdb-data:

.env (influxdb)

DOCKER_INFLUXDB_INIT_USERNAME=<username> DOCKER_INFLUXDB_INIT_PASSWORD=<password> DOCKER_INFLUXDB_INIT_ADMIN_TOKEN=<admin_token>

en wachtwoord.

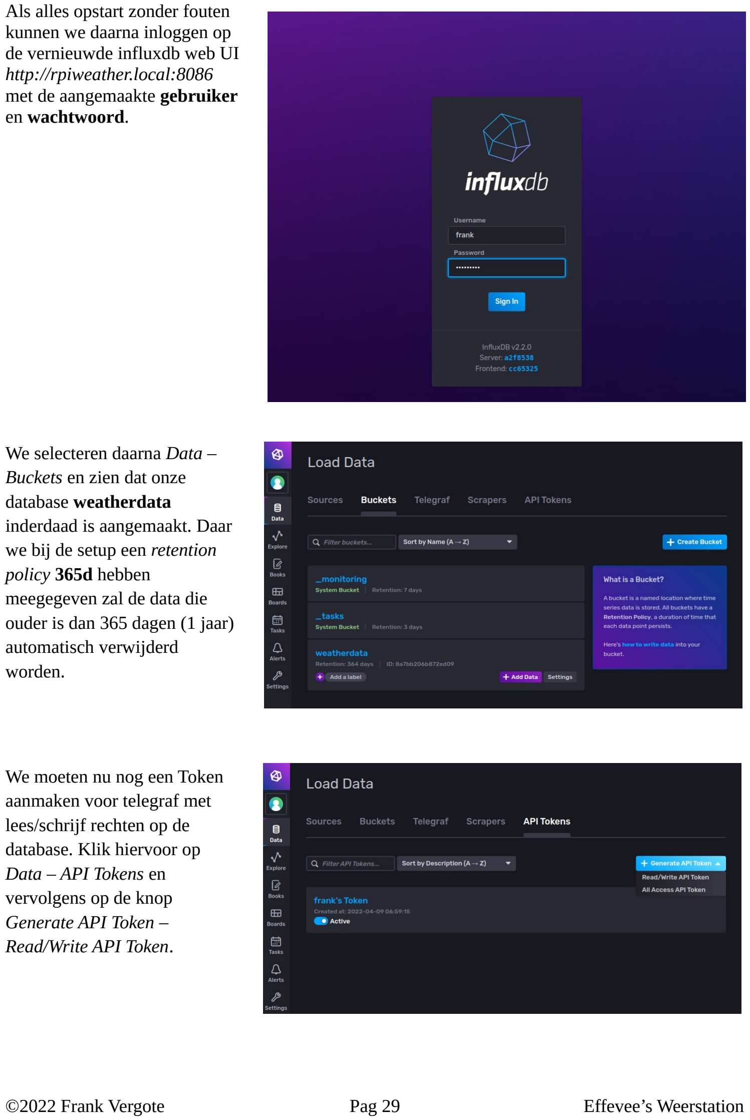
[picture p32: page 29]

Als alles opstart zonder fouten kunnen we daarna inloggen op de vernieuwde influxdb web UI http://rpiweather.local:8086 met de aangemaakte gebruiker

We selecteren daarna Data – Buckets en zien dat onze

## database weatherdata

inderdaad is aangemaakt. Daar we bij de setup een retention policy 365d hebben
meegegeven zal de data die ouder is dan 365 dagen (1 jaar) automatisch verwijderd
worden.

We moeten nu nog een Token aanmaken voor telegraf met lees/schrijf rechten op de database. Klik hiervoor op Data – API Tokens en
vervolgens op de knop
Generate API Token –
Read/Write API Token.
©2022 Frank Vergote | Pag 29 | Effevee’s Weerstation

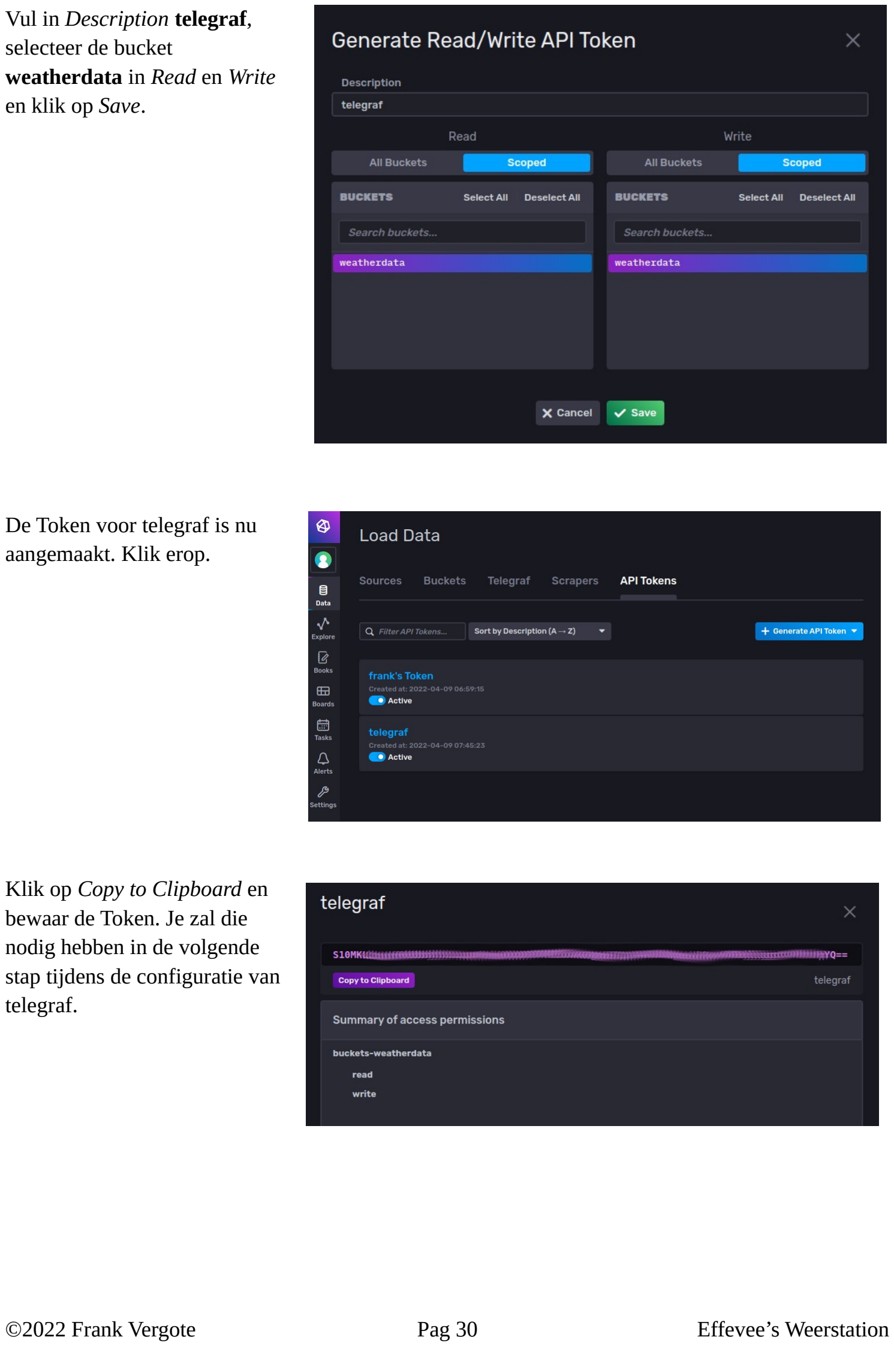
[picture p33: page 30]

Vul in Description telegraf, selecteer de bucket
weatherdata in Read en Write en klik op Save.

De Token voor telegraf is nu aangemaakt. Klik erop.

Klik op Copy to Clipboard en bewaar de Token. Je zal die nodig hebben in de volgende stap tijdens de configuratie van telegraf.

©2022 Frank Vergote | Pag 30 | Effevee’s Weerstation

## Telegraf

Telegraf werkt volledig via plugins. We zullen een lokaal configuratie bestand telegraf.conf gebruiken om alles in te stellen. Het blokje [agent] bevat algemene instellingen. De input van de data zit in [[inputs.mqtt_consumer]]. Deze definieert de MQTT server en de topic waarnaar moet geluisterd worden. [[outputs.influxdb_v2]] bepaalt de bestemming van de data : de influxdb server en de nodige informatie die nodig is om te kunnen verbinden en de data te kunnen schrijven in de database.

We configureren de image terug in het docker-compose bestand. We moeten hier in ieder geval de 3 omgevingsvariabelen definiëren die in het configuratie bestand te zien zijn, oa ook de token die we in vorige stap hebben gemaakt voor telegraf. We moeten er ook voor zorgen dat het lokale configuratie bestand gebruikt wordt. We laten de image ook pas opstarten als mosquitto en influxdb reeds operationeel zijn omdat telegraf beiden nodig heeft om zijn werk te kunnen doen. Er zijn geen named volumes gedefinieerd.

©2022 Frank Vergote | Pag 31 | Effevee’s Weerstation

telegraf.conf

[agent]
interval = "10s"
round_interval = true
metric_batch_size = 1000
metric_buffer_limit = 10000 collection_jitter = "0s"
flush_interval = "10s"
flush_jitter = "0s"
precision = ""
debug = false
quiet = false
logfile = ""
hostname = ""
omit_hostname = false

[[outputs.influxdb_v2]]
urls = ["http://influxdb:8086"]
token = "$DOCKER_INFLUXDB_TELEGRAF_TOKEN" organization = "$DOCKER_INFLUXDB_INIT_ORG" bucket = "$DOCKER_INFLUXDB_INIT_BUCKET" insecure_skip_verify = true

[[outputs.file]]
files = ["stdout", "/tmp/weatherdata.out"]

[[inputs.mqtt_consumer]]
servers = ["tcp://mosquitto:1883"]
topics = [
"weatherdata"
]
data_format = "influx"

Het in vorige stap aangemaakte telegraf token voegen we nu ook toe aan ons .env bestand zodat we in de yaml file geen gevoelige informatie moeten plaatsen.

We starten de images nu op met het gekende docker-compose up commando.

©2022 Frank Vergote | Pag 32 | Effevee’s Weerstation

docker-compose.yaml (telegraf)

version: "3.8"

services:
mosquitto:

influxdb:

telegraf:
container_name: telegraf
image: telegraf:1.22
networks:
- iot
environment:
- DOCKER_INFLUXDB_INIT_ORG=effevee
- DOCKER_INFLUXDB_INIT_BUCKET=weatherdata
- DOCKER_INFLUXDB_TELEGRAF_TOKEN=${DOCKER_INFLUXDB_TELEGRAF_TOKEN} volumes:
- ./telegraf/telegraf.conf:/etc/telegraf/telegraf.conf:ro depends_on:
- mosquitto
- influxdb

networks:
iot:

volumes:
mosquitto-data:
mosquitto-log:
influxdb-config:
influxdb-data:

.env (telegraf)

DOCKER_INFLUXDB_TELEGRAF_TOKEN=<telegraf_token>

InfluxDB dashboard

De grafieken van het dashboard maken we aan in de vernieuwde web UI van InfluxDB 2.x. De interface is heel makkelijk in gebruik en je hebt in no time een mooie voorstelling van je gegevens. Het voordeel om deze interface te gebruiken in plaats van grafana is dat je daar de nieuwe flux query taal moet gebruiken die wel wat wennen is. Bij InfluxDB kun je interactief de grafiek configureren en wordt de flux query in de achtergrond automatisch aangemaakt.

Er zijn heel wat verschillende grafiek types (https://docs.influxdata.com/influxdb/v2.2/visualize-data/visualization-types/) :

- Band
- Gauge
- Graph
- Graph + Single Stat
- Heatmap
- Histogram
- Mosaic
- Scatter
- Single Stat
- Table

De grafieken kun je makkelijk in een overzichtelijk dashboard schikken.

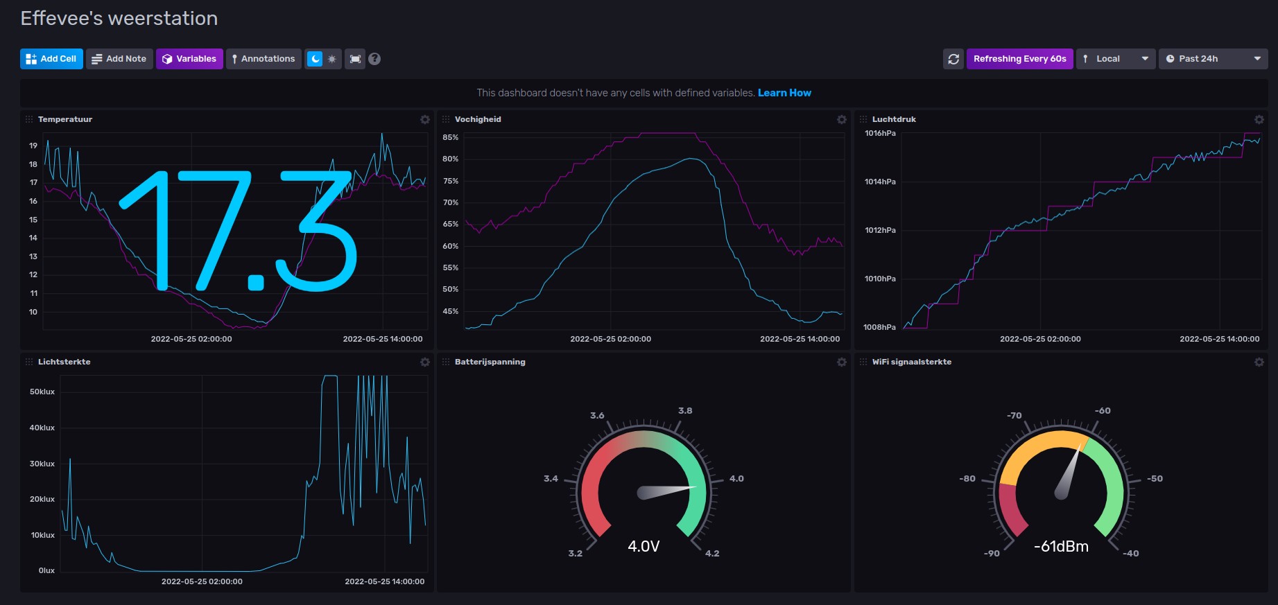
[picture p34: figure]

©2022 Frank Vergote | Pag 33 | Effevee’s Weerstation

Temperatuur

De grafiek is van het type Graph + Single Stat.

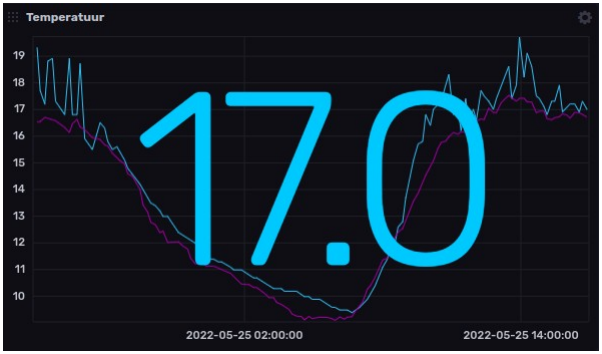
[picture p35: figure]

©2022 Frank Vergote | Pag 34 | Effevee’s Weerstation

from(bucket: "weatherdata")
|> range(start: v.timeRangeStart, stop: v.timeRangeStop)
|> filter(fn: (r) => r["_measurement"] == "actuals" or r["_measurement"] == "forecasts")
|> filter(fn: (r) => r["_field"] == "ac_temp" or r["_field"] == "ow_temp") |> aggregateWindow(every: v.windowPeriod, fn: last, createEmpty: false)
|> yield(name: "last")

Vochtigheid

De grafiek is van het type Graph.

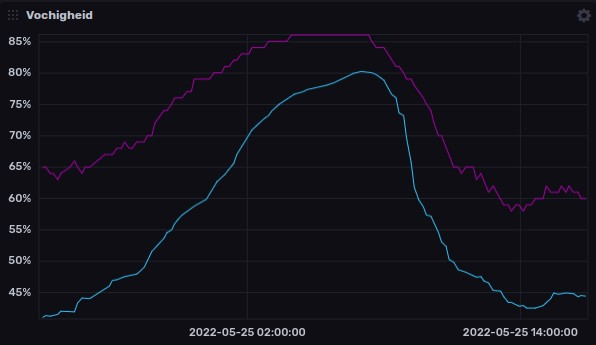
[picture p36: figure]

©2022 Frank Vergote | Pag 35 | Effevee’s Weerstation

from(bucket: "weatherdata")
|> range(start: v.timeRangeStart, stop: v.timeRangeStop)
|> filter(fn: (r) => r["_measurement"] == "actuals" or r["_measurement"] == "forecasts")
|> filter(fn: (r) => r["_field"] == "ac_hum" or r["_field"] == "ow_hum") |> aggregateWindow(every: v.windowPeriod, fn: mean, createEmpty: false)
|> yield(name: "mean")

Luchtdruk

De grafiek is van het type Graph.

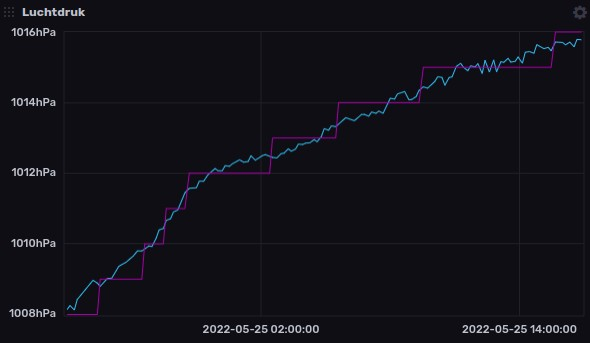
[picture p37: figure]

©2022 Frank Vergote | Pag 36 | Effevee’s Weerstation

from(bucket: "weatherdata")
|> range(start: v.timeRangeStart, stop: v.timeRangeStop)
|> filter(fn: (r) => r["_measurement"] == "actuals" or r["_measurement"] == "forecasts")
|> filter(fn: (r) => r["_field"] == "ac_pres" or r["_field"] == "ow_pres") |> aggregateWindow(every: v.windowPeriod, fn: mean, createEmpty: false)
|> yield(name: "mean")

Lichtsterkte

De grafiek is van het type Graph.

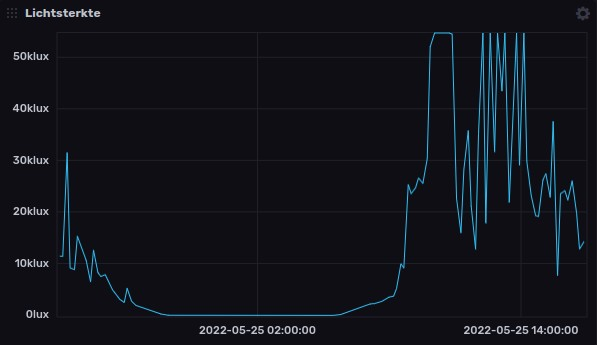
[picture p38: figure]

©2022 Frank Vergote | Pag 37 | Effevee’s Weerstation

from(bucket: "weatherdata")
|> range(start: v.timeRangeStart, stop: v.timeRangeStop)
|> filter(fn: (r) => r["_measurement"] == "actuals" or r["_measurement"] == "forecasts")
|> filter(fn: (r) => r["_field"] == "ac_lum")
|> aggregateWindow(every: v.windowPeriod, fn: mean, createEmpty: false)
|> yield(name: "mean")

Batterijspanning

De grafiek is van het type Gauge.

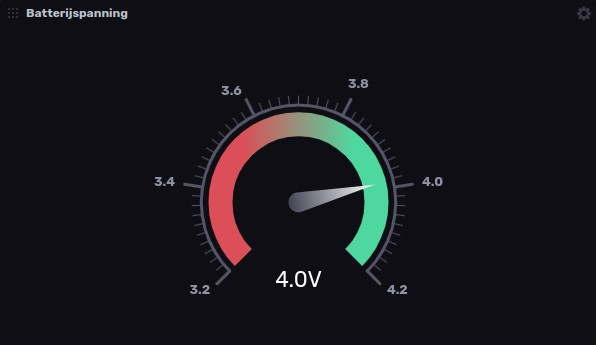
[picture p39: figure]

©2022 Frank Vergote | Pag 38 | Effevee’s Weerstation

from(bucket: "weatherdata")
|> range(start: v.timeRangeStart, stop: v.timeRangeStop)
|> filter(fn: (r) => r["_measurement"] == "actuals")
|> filter(fn: (r) => r["_field"] == "ac_batv")
|> aggregateWindow(every: v.windowPeriod, fn: mean, createEmpty: false) |> yield(name: "mean")

WiFi signaalsterkte

De grafiek is van het type Gauge.

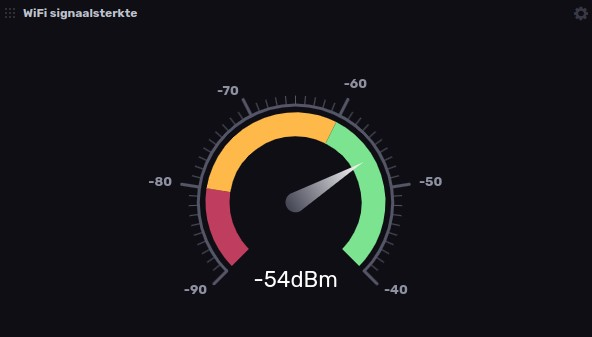
[picture p40: figure]

©2022 Frank Vergote | Pag 39 | Effevee’s Weerstation

from(bucket: "weatherdata")
|> range(start: v.timeRangeStart, stop: v.timeRangeStop)
|> filter(fn: (r) => r["_measurement"] == "actuals")
|> filter(fn: (r) => r["_field"] == "ac_rssi")
|> aggregateWindow(every: v.windowPeriod, fn: last, createEmpty: false) |> yield(name: "last")

InfluxDB monitoring

InfluxDB2 heeft de mogelijkheid om te controleren als bepaalde waarden overschreden worden (threshold checks) of niet meer binnenkomen (deadman checks). De statussen van deze checks (CRIT, WARN, INFO of OK) worden op hun beurt opgeslagen in de systeem bucket _monitoring. Aan de hand van de gegevens in deze tabellen kunnen we vervolgens waarschuwingen genereren die we bijvoorbeeld via email kunnen versturen.

In ons geval zullen de volgende parameters gemonitord worden :
- controle batterijspanning : het meetstation wordt gevoed met een lithium ion 18650 batterij die via een zonnepaneeltje en een TP4056 wordt bijgeladen. Een LDO HT7333 spanningsregelaar zorgt voor een constante spanning van 3.3V voor de voeding van de ESP32 en de sensoren. Het is dus belangrijk dat de spanning van de batterij boven de 3.4V blijft voor de goede werking. Hiervoor zullen we een threshold check aanmaken.
- controle meetstation : het niet meer doorsturen van gegevens kan verschillende oorzaken hebben: ESP32 kan geen Wifi connectie maken, voeding meetstation defect, ESP32 gecrasht, … Hiervoor zullen we een deadman check aanmaken.

We beginnen met het aanmaken van de controle checks. De documentatie vind je hier. (https://docs.influxdata.com/influxdb/v2.2/monitor-alert/checks/create/)

Controle batterijspanning

We klikken op Alerts en vervolgens op Create – Threshold Check. We selecteren 1. Define Query. We kiezen het veld ac_batv uit de tabel actuals van de weatherdata database. Enkel de laatste waarde (last) wordt geselecteerd. Klik op Submit

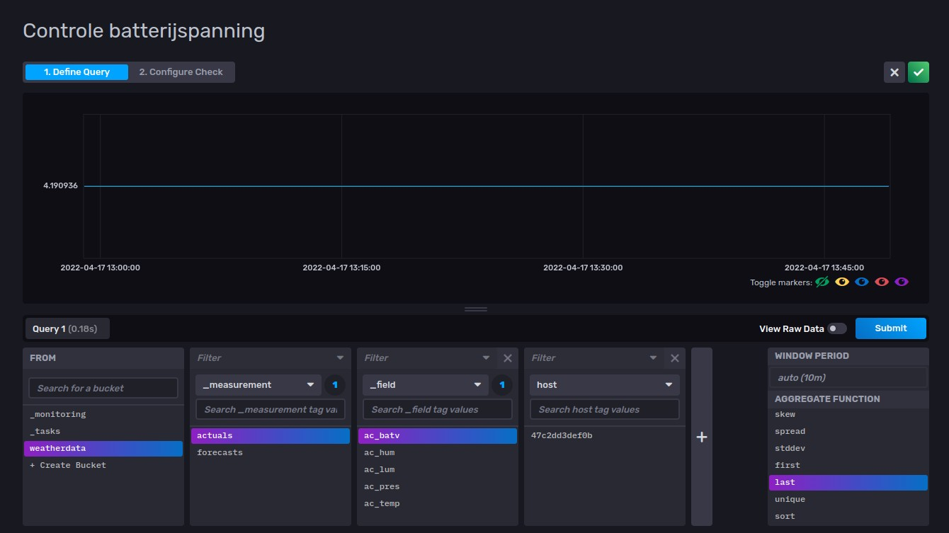
[picture p41: figure]

©2022 Frank Vergote | Pag 40 | Effevee’s Weerstation

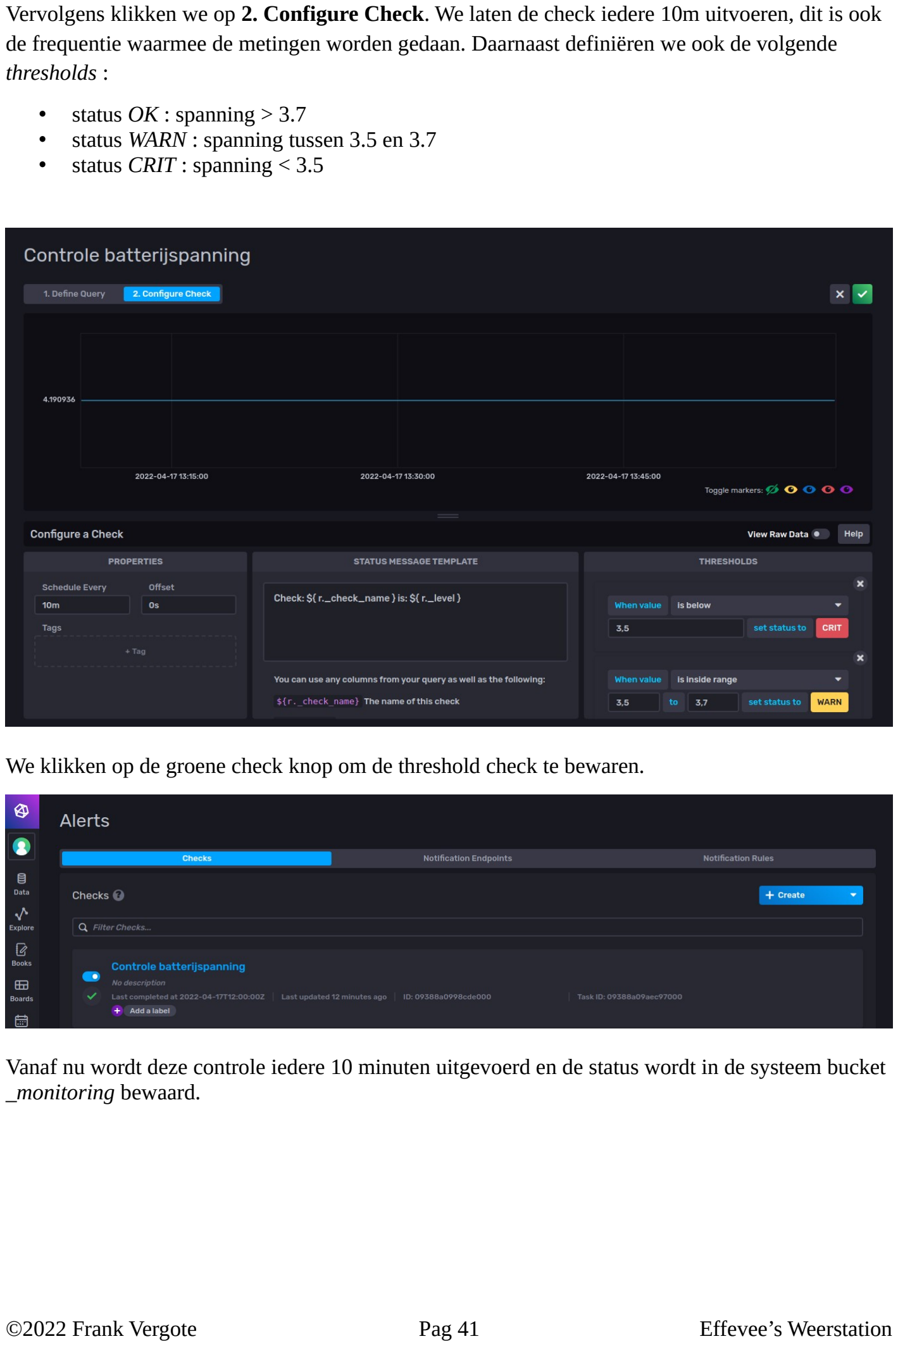
[picture p42: page 41]

Vervolgens klikken we op 2. Configure Check. We laten de check iedere 10m uitvoeren, dit is ook de frequentie waarmee de metingen worden gedaan. Daarnaast definiëren we ook de volgende thresholds :

- status OK : spanning > 3.7
- status WARN : spanning tussen 3.5 en 3.7
- status CRIT : spanning < 3.5

We klikken op de groene check knop om de threshold check te bewaren.

Vanaf nu wordt deze controle iedere 10 minuten uitgevoerd en de status wordt in de systeem bucket _monitoring bewaard.

©2022 Frank Vergote | Pag 41 | Effevee’s Weerstation

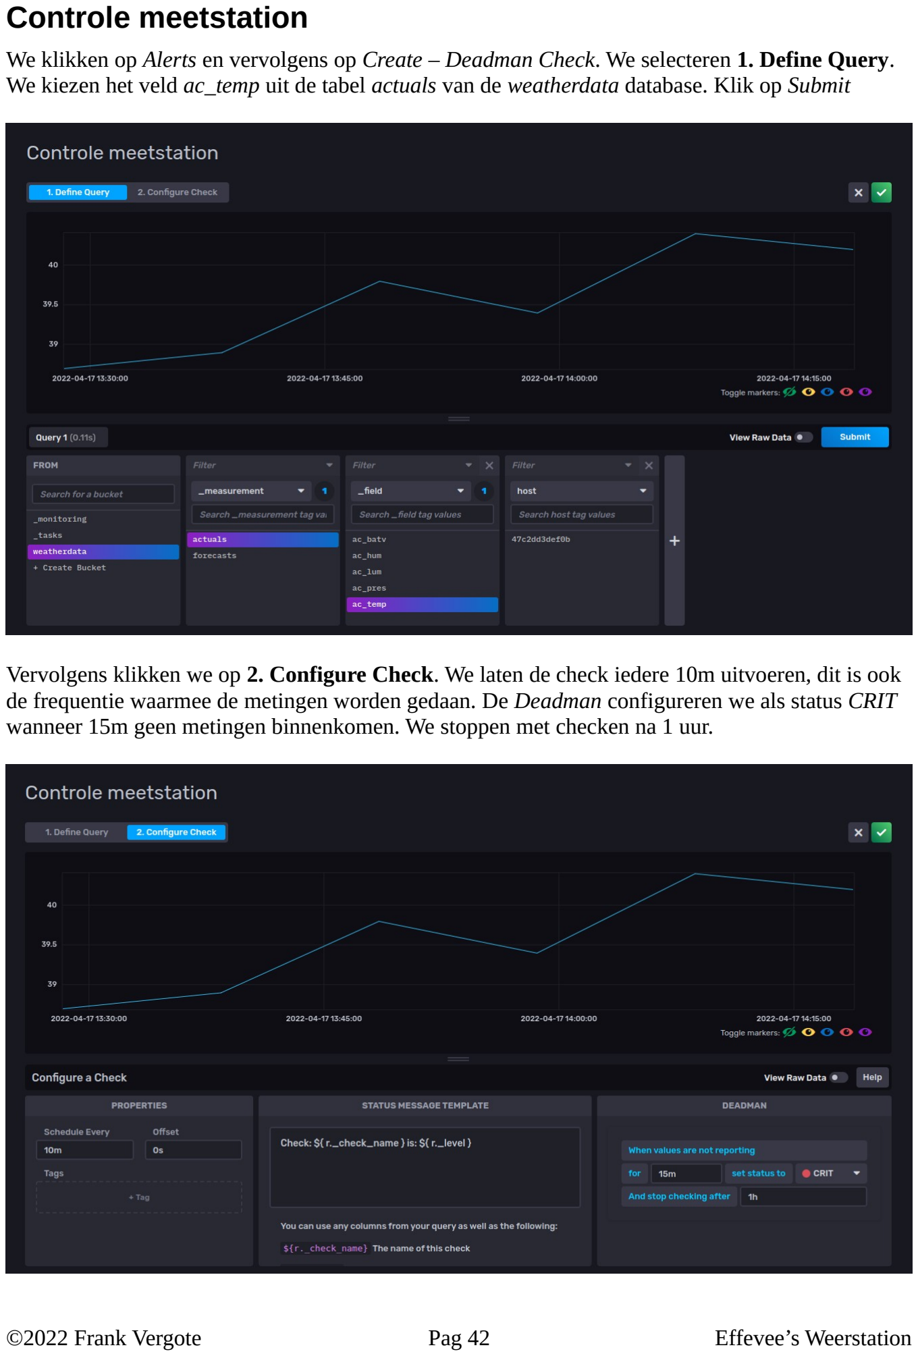
[picture p43: page 42]

Controle meetstation

We klikken op Alerts en vervolgens op Create – Deadman Check. We selecteren 1. Define Query. We kiezen het veld ac_temp uit de tabel actuals van de weatherdata database. Klik op Submit

Vervolgens klikken we op 2. Configure Check. We laten de check iedere 10m uitvoeren, dit is ook de frequentie waarmee de metingen worden gedaan. De Deadman configureren we als status CRIT wanneer 15m geen metingen binnenkomen. We stoppen met checken na 1 uur.

©2022 Frank Vergote | Pag 42 | Effevee’s Weerstation

We klikken op de groene check knop om de deadman check te bewaren.

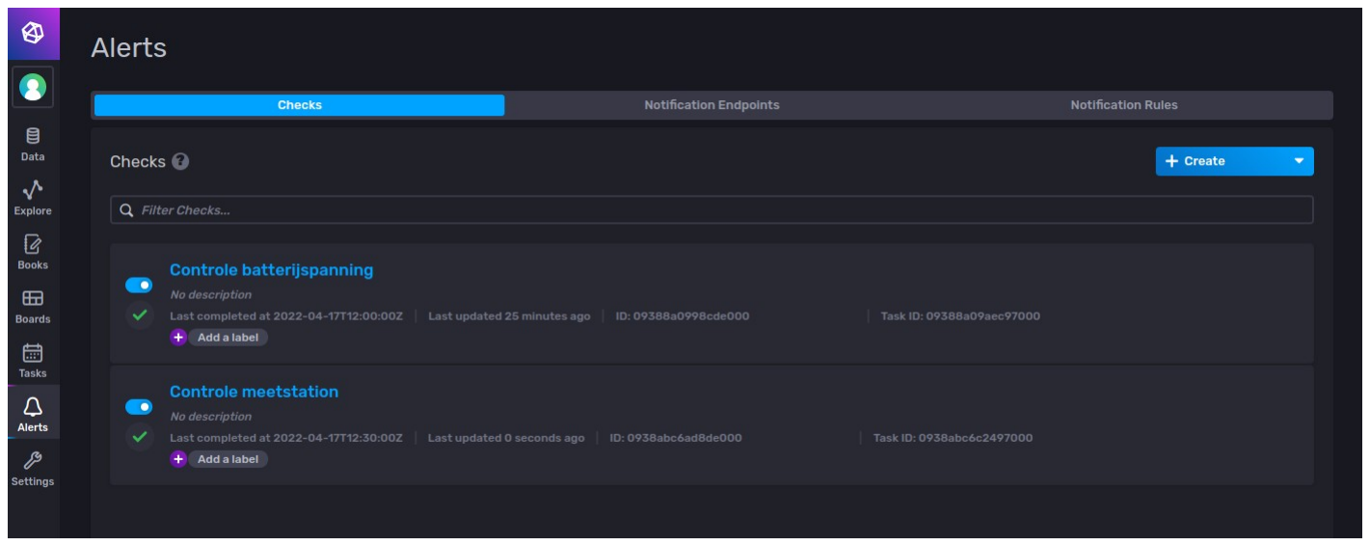
[picture p44: figure]

Vanaf nu wordt deze controle iedere 10 minuten uitgevoerd en de status wordt in de systeem bucket _monitoring bewaard.

SendGrid e-mail service

InfluxDB heeft jammer genoeg geen eigen ingebouwde email mogelijkheid, maar kan gebruik maken van diverse externe email services (SendGrid, Amazon SES, Mailjet, Mailgun). De documentatie erover vind je hier. (https://docs.influxdata.com/influxdb/v2.2/monitor-alert/send-email/)

Hier volgt verkort de set-up van de SendGrid (https://sendgrid.com/) e-mail service die een gratis service aanbiedt beperkt tot 100 e-mails per dag. Dat is ruim voldoende voor ons gebruik, daar we alleen e-mails gaan versturen bij kritische situaties.

We beginnen met een account aan te maken
met een email adres en paswoord (min 16
karakters). Er worden ook een aantal persoonlijke gegevens gevraagd zoals naam, adres, firma, … Maar geen kredietkaart nummer ;-)

Vervolgens wordt een email verstuurd om je account te verifiëren/activeren. Je kan nu inloggen op http://app.sendgrid.com

Voor de veiligheid wordt je de eerste keer verplicht om dubbele authenticatie te activeren via een app of sms.

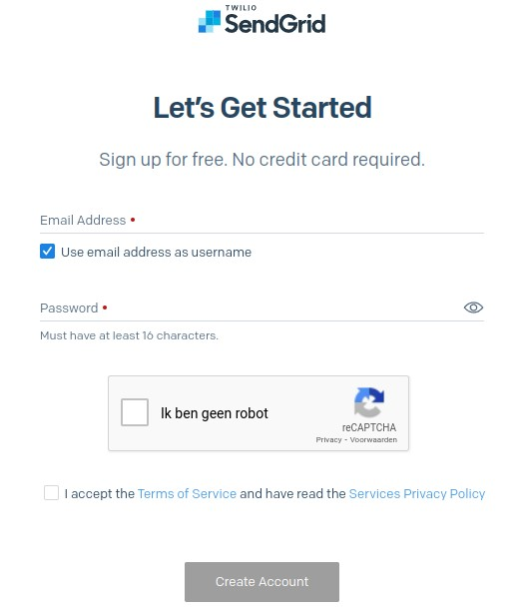
[picture p45: figure]

©2022 Frank Vergote | Pag 43 | Effevee’s Weerstation

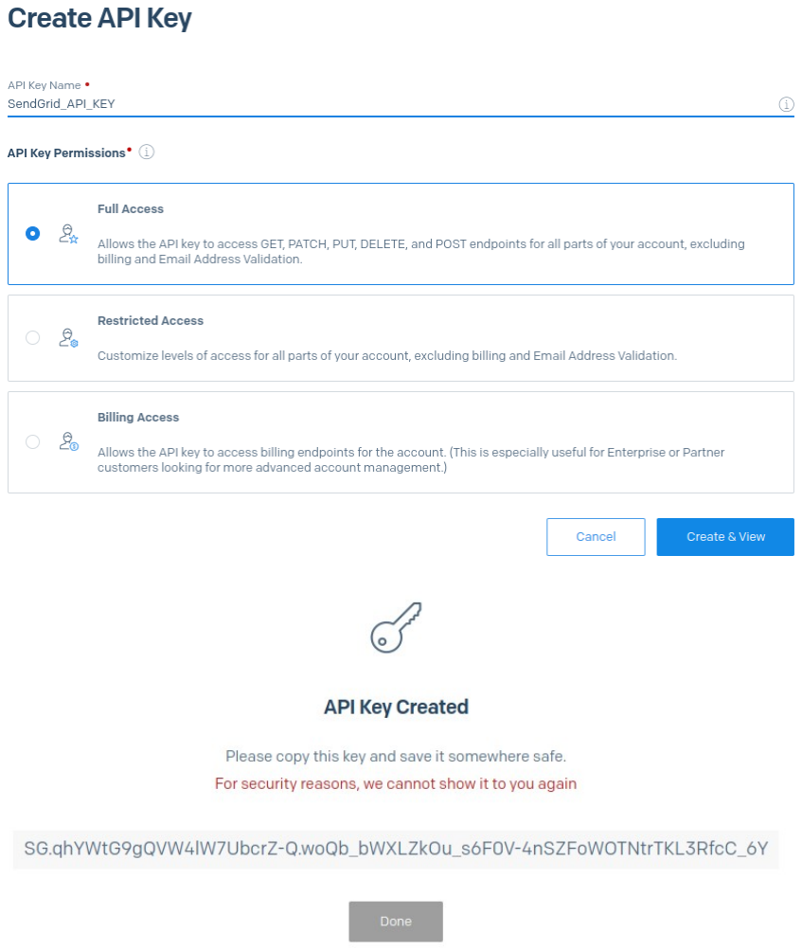
[picture p46: figure]

Om de integratie met InfluxDB mogelijk te maken moet je nu een SendGrid API key genereren via Settings – API Keys

Geef de API Key een naam, kies de gewenste rechten (Full Access) en klik op de Create & View knop.

De API key wordt getoond. Kopieer die voorlopig op een veilige plaats. We gaan die later nodig hebben in ons InfluxDB script om e-mails te versturen.

We zullen deze API key nu opslaan in het InfluxDB secrets bestand. Hiervoor selecteren we in de UI interface achtereenvolgens Settings, Secrets en de knop Add Secret. Geef de Key een naam en kopieer de eerder aangemaakte
SendGrid API key in het Value
veld. Klik vervolgens op de knop

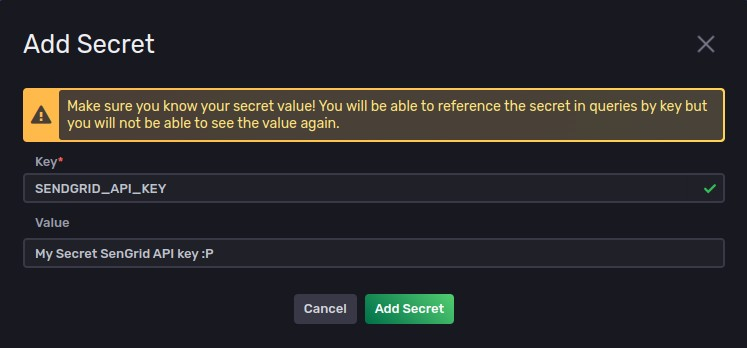
[picture p47: figure]

Add Secret. Op die manier wordt geen gevoelige informatie in de e-mail scripts gebruikt, enkel de verwijzing naar de plaats waar de secrets zich bevinden.

We zijn nu klaar om onze e-mail scripts aan te maken. We zullen hiervoor Tasks gebruiken.

©2022 Frank Vergote | Pag 44 | Effevee’s Weerstation

Batterij waarschuwing e-mail

We definieren een nieuwe taak via
Tasks – Create Task. We geven de
taak een Name en een Schedule. In
ons geval laten we de taak om het uur lopen.

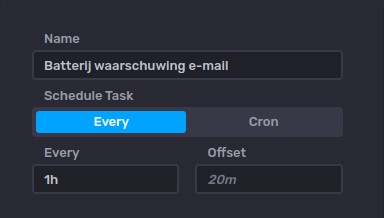
[picture p48: figure]

In het script lezen we de SendGrid API key uit het secrets bestand, laten we een query lopen die het aantal kritische statussen van de batterij berekent tijdens het laatste uur en verstuurt een e-mail via de SendGrid e-mail service als dat aantal groter dan 3 is.

©2022 Frank Vergote | Pag 45 | Effevee’s Weerstation

Batterij waarschuwing e-mail

import "http"
import "json"
import "influxdata/influxdb/secrets"

option task = {name: "Batterij waarschuwing e-mail", every: 1h}

SENDGRID_APIKEY = secrets.get(key: "SENDGRID_APIKEY")

numberOfBatteryCrits =
from(bucket: "_monitoring")
|> range(start: -task.every)
|> filter(fn: (r) => r._measurement == "statuses" and r._field == "ac_batv" and r._level == "crit") |> count()

numberOfBatteryCrits
|> map(
fn:
(r) =>
if r._value > 3 then
{r with _value:
http.post(
url: "https://api.sendgrid.com/v3/mail/send", headers: {
"Content-Type": "application/json", "Authorization": "Bearer ${SENDGRID_APIKEY}", },
data:
json.encode(
v:
{
"personalizations": [{"to": [{"email": "effevee@gmail.com"}]}], "from": {"email": "effevee@gmail.com"},
"subject": "Effevee's weerstation waarschuwing",
"content":
[
{
"type": "text/plain",
"value":
"Opgelet: de batterijspanning van het meetstation heeft meer dan ${r._value} kritische statussen.", },
],
},
),
),
}
else
{r with _value: 0},
)

Meetstation waarschuwing e-mail

We definieren een nieuwe taak via
Tasks – Create Task. We geven de
taak een Name en een Schedule. In
ons geval laten we de taak om het uur lopen.

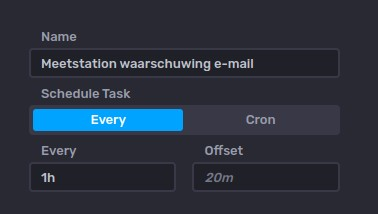
[picture p49: figure]

In het script lezen we de SendGrid API key uit het secrets bestand, laten we een query lopen die het aantal kritische statussen (dead == true) berekent tijdens het laatste uur en verstuurt een e-mail via de SendGrid e-mail service als dat aantal groter dan 3 is.

©2022 Frank Vergote | Pag 46 | Effevee’s Weerstation

Meetstation waarschuwing e-mail

import "http"
import "json"
import "influxdata/influxdb/secrets"

option task = {name: "Meetstation waarschuwing e-mail", every: 1h}

SENDGRID_APIKEY = secrets.get(key: "SENDGRID_APIKEY")

numberOfDeads =
from(bucket: "_monitoring")
|> range(start: -task.every)
|> filter(fn: (r) => r._measurement == "statuses" and r._field == "dead" and r._value == true) |> count()

numberOfDeads
|> map(
fn:
(r) =>
if r._value > 3 then
{r with _value:
http.post(
url: "https://api.sendgrid.com/v3/mail/send", headers: {
"Content-Type": "application/json", "Authorization": "Bearer ${SENDGRID_APIKEY}", },
data:
json.encode(
v:
{
"personalizations": [{"to": [{"email": "effevee@gmail.com"}]}], "from": {"email": "effevee@gmail.com"},
"subject": "Effevee's weerstation waarschuwing",
"content":
[
{
"type": "text/plain",
"value":
"Opgelet: het meetstation heeft reeds meer dan $ {r._value} maal geen gegevens verstuurd.", },
],
},
),
),
}
else
{r with _value: 0},
)

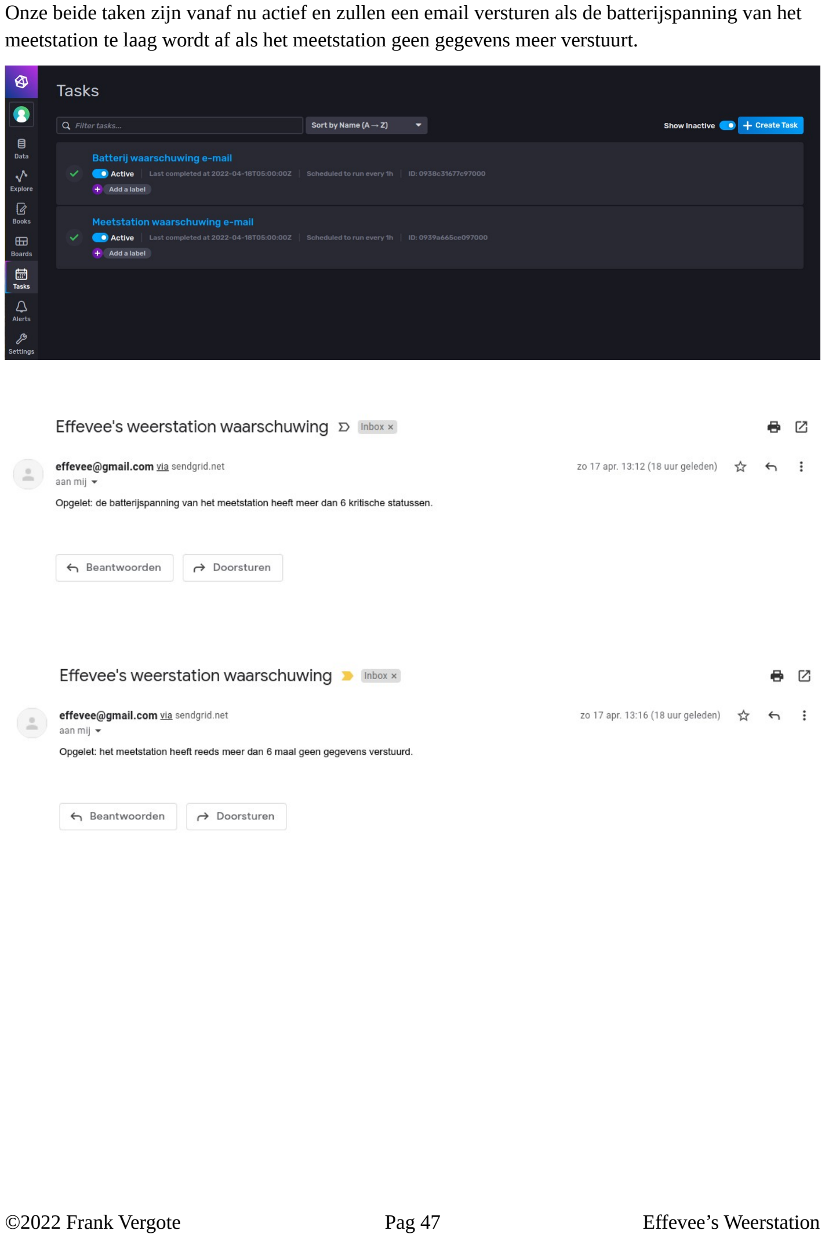
[picture p50: page 47]

Onze beide taken zijn vanaf nu actief en zullen een email versturen als de batterijspanning van het meetstation te laag wordt af als het meetstation geen gegevens meer verstuurt.

©2022 Frank Vergote | Pag 47 | Effevee’s Weerstation

Update 8/11/2023

SHT30 temperatuur en vochtigheid buitensensor

Het valt op dat de AM2320 niet echt geschikt is om in de ‘buitenlucht’ te werken. Met name de relatieve vochtigheid geeft bijna altijd 100% aan, uitgezonderd bij echt droog weer met lage luchtvochtigheid. Daarom zocht ik naar een betere sensor voor de temperatuur en vochtigheidsmeting.

Die vond ik in deze SHT30 outdoor sensor. (https://www.aliexpress.com/item/1005006011437324.html) Het beschermend omhulsel zorgt ervoor dat er geen condensatie wordt gevormd die valse metingen veroorzaken. De sensor is aan te sturen via I2C op adres 0x44.

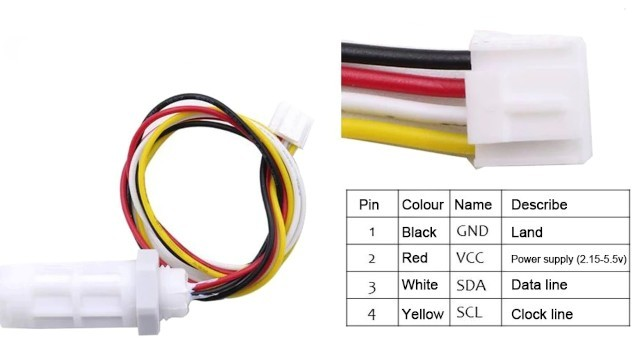
[picture p51: figure]

Intern bevat de sensor een Sensirion (https://www.mouser.com/datasheet/2/682/Sensirion_Humidity_Sensors_SHT3x_Datasheet_digital-971521.pdf) chip. Gelukkig is er een MicroPython SHT30 module beschikbaar om de sensor eenvoudig te kunnen uitlezen.

Module | Beschrijving | Installatie
sht30 | Sensirion SHT30 I2C driver | https://github.com/rsc1975/micropython-sht30

De aangepaste source code kan je hier (https://github.com/effevee/effevees_weerstation/blob/main/meetstation/source/esp32/meetstation_sht30.py) vinden.

©2022 Frank Vergote | Pag 48 | Effevee’s Weerstation

Bijlagen

Datasheets

- ESP32- (https://www.espressif.com/sites/default/files/documentation/esp32-wroom-32_datasheet_en.pdf) WROOM-32 (https://www.espressif.com/sites/default/files/documentation/esp32-wroom-32_datasheet_en.pdf) microcontroller
- AM23 (https://cdn-shop.adafruit.com/product-files/3721/AM2320.pdf) 20 (https://cdn-shop.adafruit.com/product-files/3721/AM2320.pdf) temperatuur- en vochtigheidssensor
- SHT30 (https://www.mouser.com/datasheet/2/682/Sensirion_Humidity_Sensors_SHT3x_Datasheet_digital-971521.pdf) temperatuur- en vochtigheid buitensensor
- BMP180 (https://cdn-shop.adafruit.com/datasheets/BST-BMP180-DS000-09.pdf) luchtdruk- en temperatuursensor
- BH175 (https://www.mouser.com/datasheet/2/348/bh1750fvi-e-186247.pdf) 0FVI (https://www.mouser.com/datasheet/2/348/bh1750fvi-e-186247.pdf) lichtintensiteit sensor
- TP40 (https://dlnmh9ip6v2uc.cloudfront.net/datasheets/Prototyping/TP4056.pdf) 5 (https://dlnmh9ip6v2uc.cloudfront.net/datasheets/Prototyping/TP4056.pdf) 6 (https://dlnmh9ip6v2uc.cloudfront.net/datasheets/Prototyping/TP4056.pdf) lithium ion batterij laadcontroller
- DW01A (https://datasheet.lcsc.com/szlcsc/1901091236_PUOLOP-DW01A_C351410.pdf) lithium ion batterij bescherming
- HT73333 (https://datasheet.lcsc.com/szlcsc/Holtek-Semicon-HT7333-A_C21583.pdf) 3,3V LDO spanningsregelaar

Referenties

- Power ESP32/ESP8266 with Solar Panels (includes battery level monitoring) (https://randomnerdtutorials.com/power-esp32-esp8266-solar-panels-battery-level-monitoring/)
- Cheap and simple Solar Power for our small Projects (ESP32, ESP8266, Arduino) (https://youtu.be/37kGva3NW8w)
- ESP32 / BC24 Extending your WiFi Range (https://www.switchdoc.com/2018/06/tutorial-extending-your-wifi-range-on-the-esp32-bc24/)
- Docker Tutorial for Beginners [FULL COURSE in 3 Hours] (https://youtu.be/3c-iBn73dDE)
- InfluxDB reference (https://docs.influxdata.com/influxdb/v2.2/reference/)
- Running InfluxDB 2.0 and Telegraf Using Docker (https://www.influxdata.com/blog/running-influxdb-2-0-and-telegraf-using-docker/)
- Handling IOT data with MQTT, Telegraf, InfluxDB and Grafana (https://lucassardois.medium.com/handling-iot-data-with-mqtt-telegraf-influxdb-and-grafana-5a431480217)
- How to Use docker-compose Environment Variables (https://adamtheautomator.com/docker-compose-environment-variables/)
©2022 Frank Vergote | Pag 49 | Effevee’s Weerstation

Docker commando’s

Commando | Beschrijving
docker --version | Versie van docker client en server
docker pull <image> | Docker <image> downloaden van Docker Hub
docker images | Toont alle gedownloade docker images
docker rmi <image> | Verwijdert <image>
docker run -it -d <image> | Start <image> in vrijstaande (detached) modus
docker ps | Toont alle draaiende docker containers
docker ps -a | Toont alle docker containers
docker exec -it <container> <command> | Voert <command> uit in docker <container>
docker container ls -a | Toont alle docker containers (draaiende en gestopte)
docker container prune | Verwijdert alle gestopte docker containers
docker rm <container> | Verwijdert <container> (moet gestopt zijn!)
docker restart <container> | Herstart draaiende <container>
docker stop <container> | Stopt draaiende <container>
docker start <container> | Start gestopte <container>
docker network ls | Toont alle netwerk interfaces
docker network create <network> | Maakt een nieuw <network> aan
docker logs <container> | Toont de logs van <container>
docker logs -f <container> | Monitor de logs van <container> (follow optie)
docker volume ls | Toont alle volumes (blijvende data)
docker volume inspect <volume> | Toont gedetailleerde informatie over <volume>
docker volume prune | Verwijdert alle ongebruikte volumes
docker volume rm <volume> | Verwijdert <volume> van gestopte container
©2022 Frank Vergote | Pag 50 | Effevee’s Weerstation

Docker-compose commando’s

Commando* | Beschrijving
docker-compose up -d | Maakt en start alle containers van docker-compose.yaml in detached modus
docker-compose down | Stopt en verwijdert alle containers van docker-compose.yaml
docker-compose logs -f | Monitort de logs van alle containers van docker-compose.yaml
docker-compose restart | Herstart alle services van docker-compose.yaml
docker-compose stop | Stopt alle services van docker-compose.yaml
docker-compose start | Start alle services van docker-compose.yaml

* Alle docker-compose commando’s moeten uitgevoerd worden in de directory waar zich de docker-compose.yaml configuratie bevindt.

©2022 Frank Vergote | Pag 51 | Effevee’s Weerstation
