effevee/effevees_weerstation/meetstation/pcb/pcb_meetstation.png

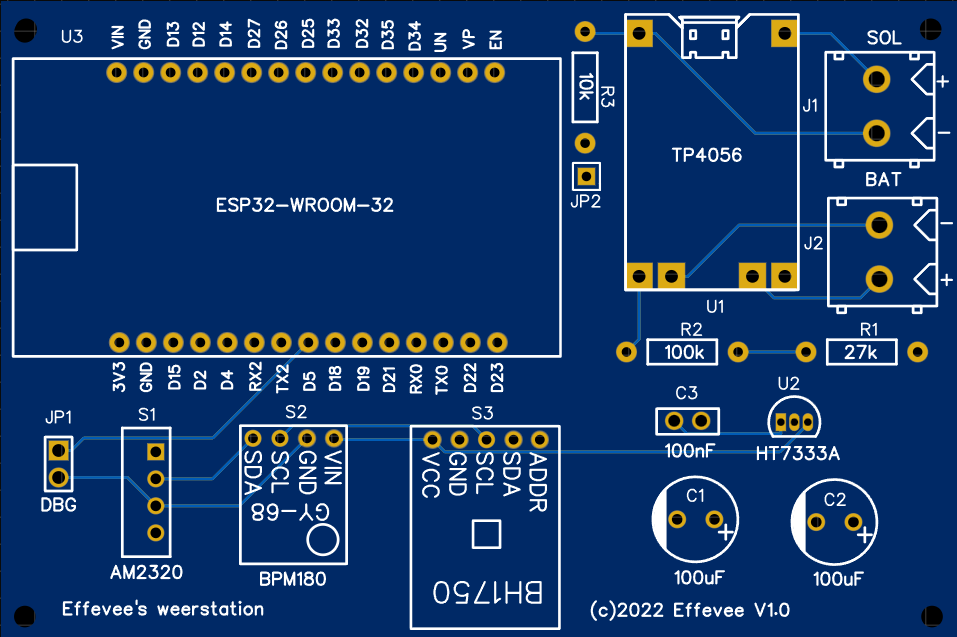
meetstation/pcb/pcb_meetstation.png
