effevee/effevees_weerstation/meetstation/behuizing/Screen_Top_Cover.STEP

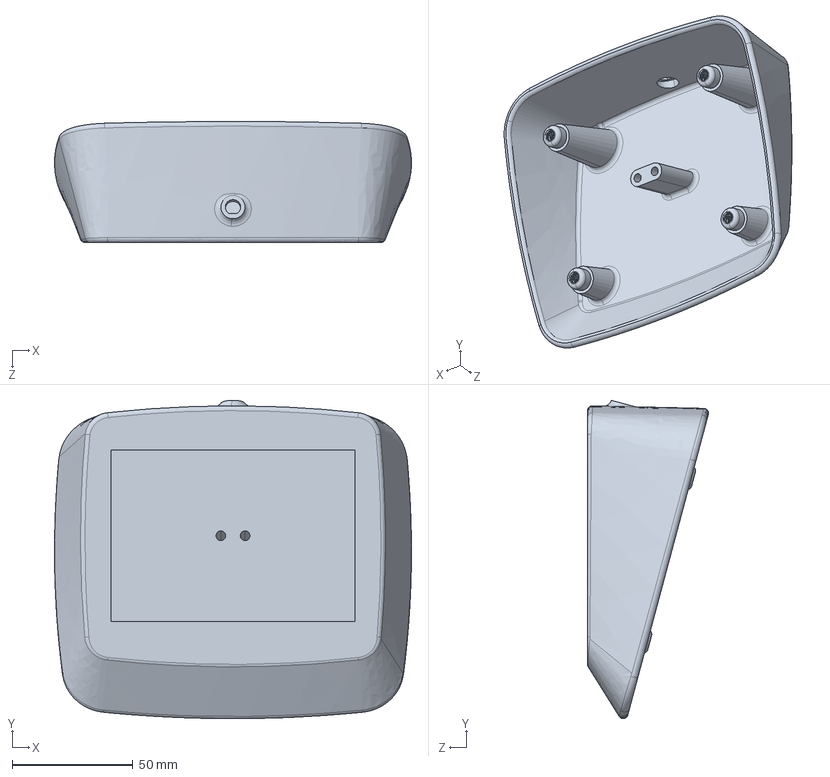
[picture p53: CAD file, 2022-04-21]
meetstation/behuizing/Screen_Top_Cover.STEP
147.8 x 131.8 x 50.1 mm
