effevee/effevees_weerstation/meetstation/behuizing/Stevenson_Screen_PCB_Mount_Frame.STL

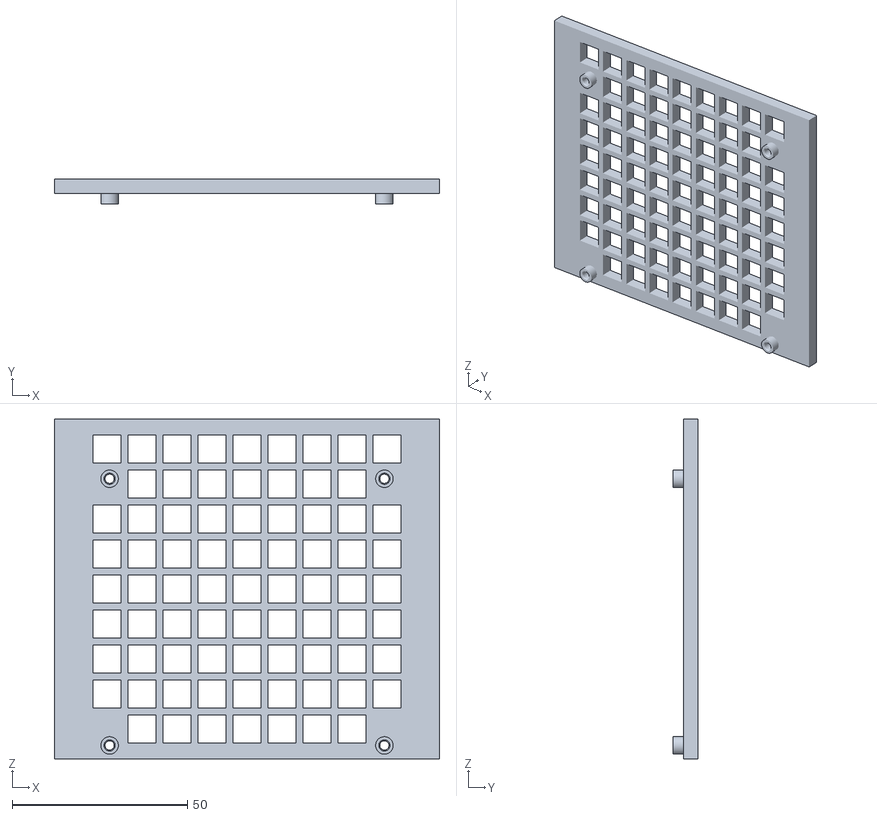
[picture p54: CAD file, 2022-04-21]
meetstation/behuizing/Stevenson_Screen_PCB_Mount_Frame.STL
110.0 x 7.00 x 97.0
