effevee/effevees_weerstation/meetstation/pcb/Schematic_Effevee's weather station.pdf

TP4056

## Power Supply

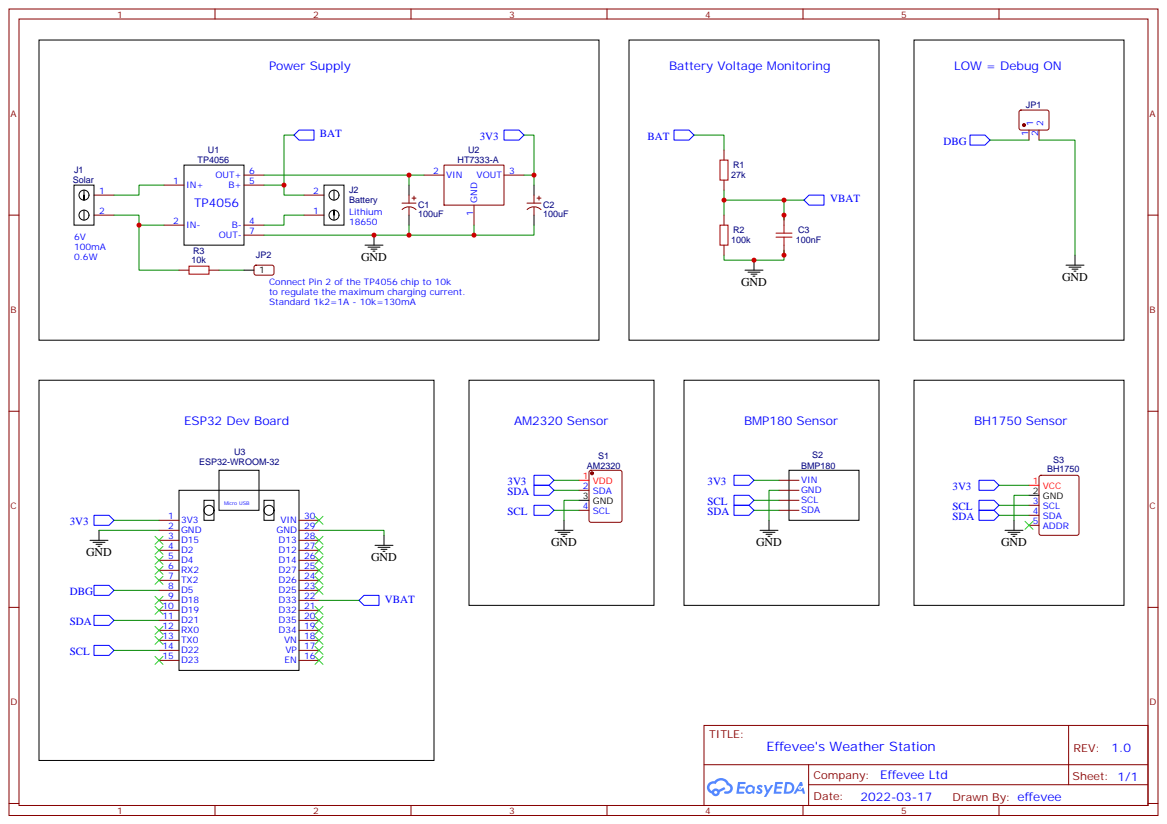
[picture p55: page 1]

Connect Pin 2 of the TP4056 chip to 10k
to regulate the maximum charging current.
Standard 1k2=1A - 10k=130mA
